rasero3/Nanopipets/README.md

# Nanopipets

MatLab(UART) --> FPGA(UART-SPI) --> DAC
ADC(SPI) --> FPGA(SPI-UART) --> MatLab(UART)

El DAC genera picos de la tension deseada cada 10Hz
