rasero3/Nanopipets/KiCad/Nanopipetes/Nanopipetes.kicad_pcb

## KiCad design KiCad/Nanopipetes/Nanopipetes.kicad_pcb (2025-12-02)

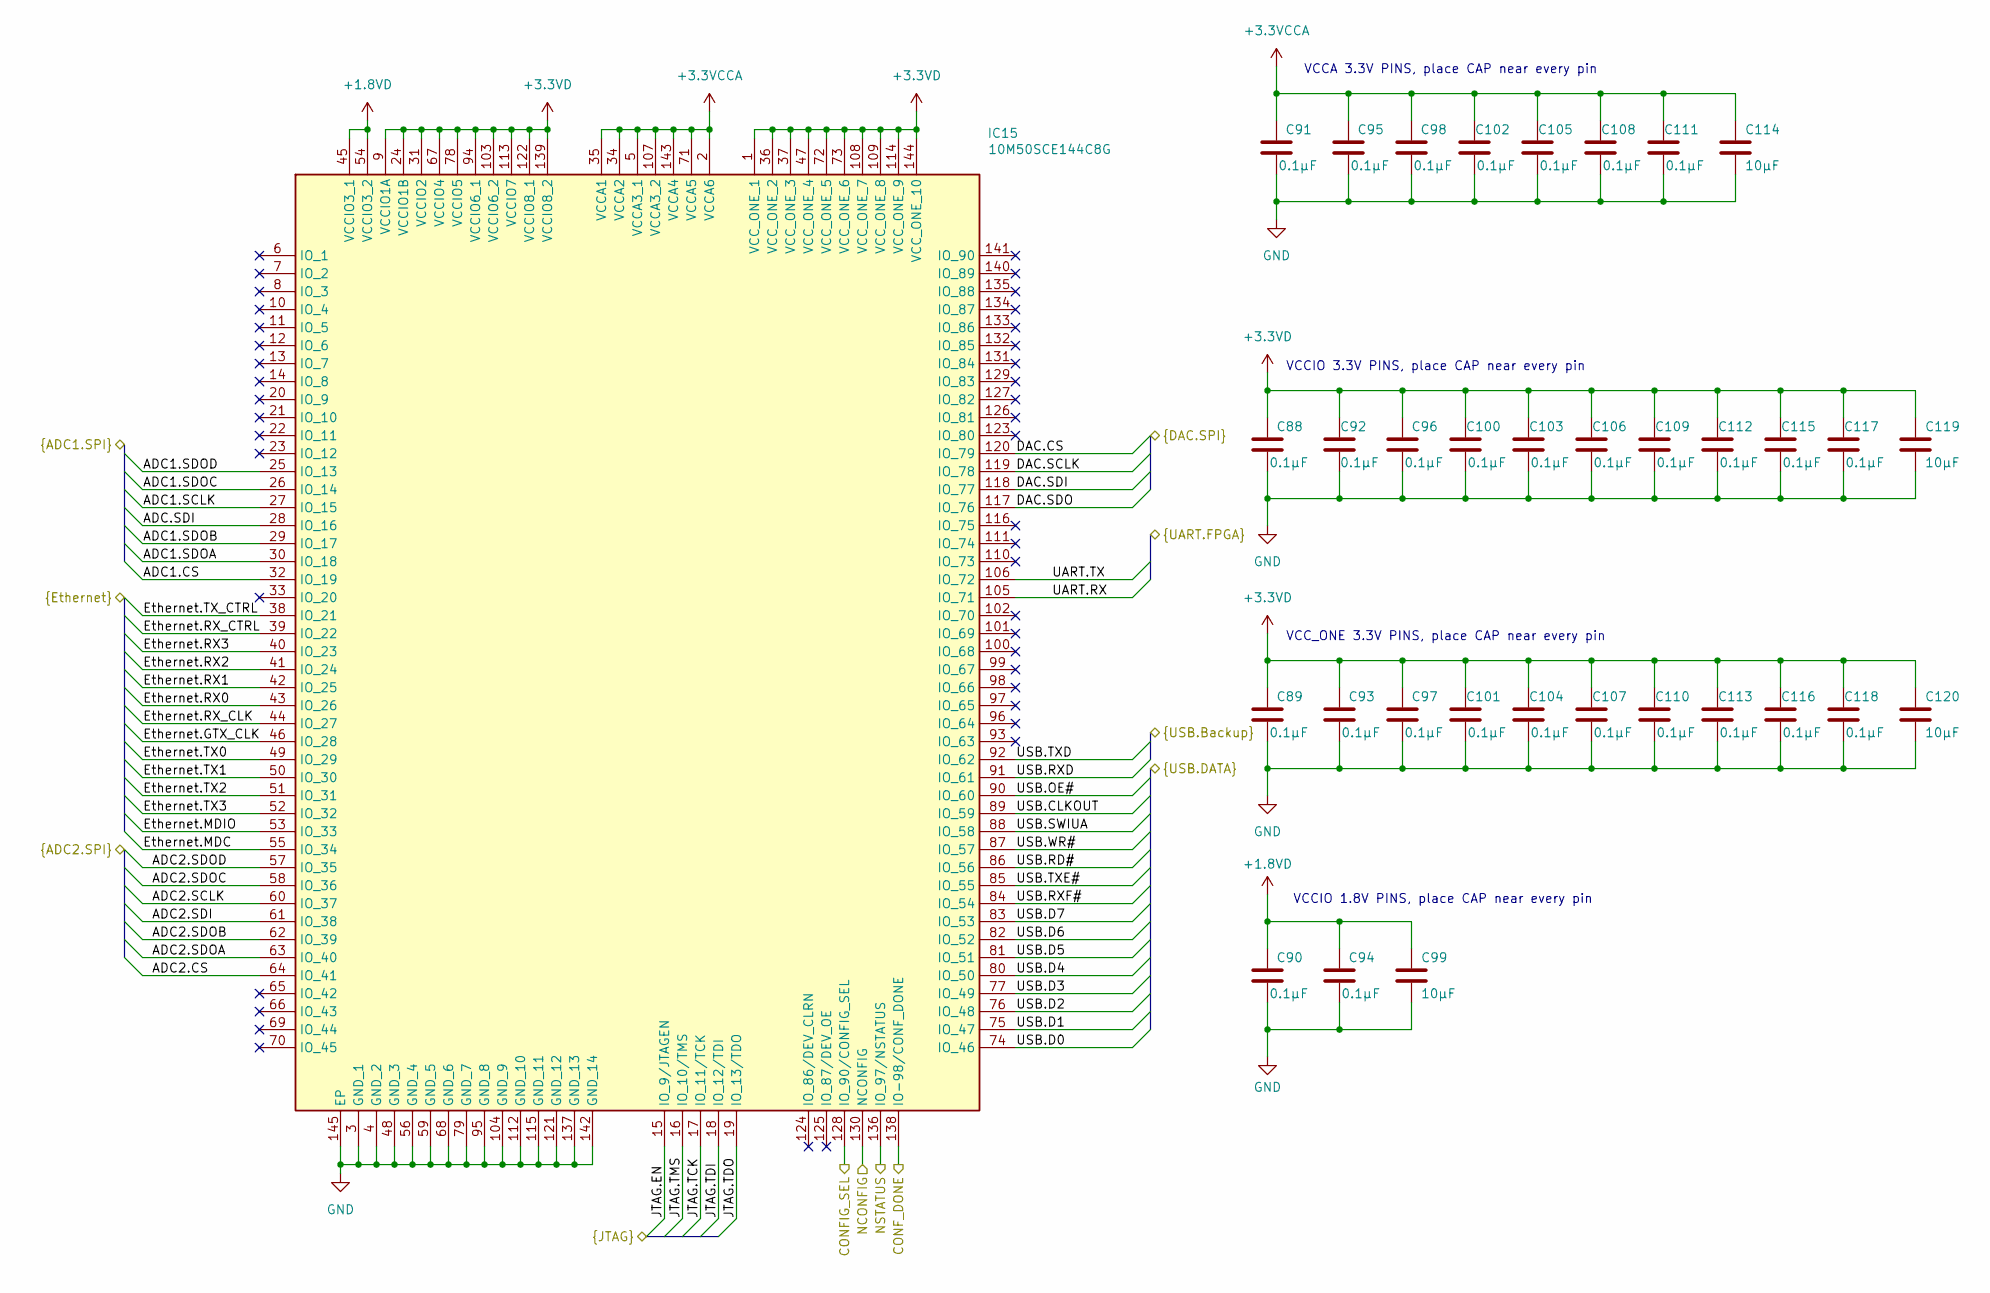
[picture p1: schematic FPGA.kicad_sch]

Parts:
C88, C89, C90, C91, C92, C93, C94, C95, C96, C97, C98, C100, C101, C102, C103, C104, C105, C106, C107, C108, C109, C110, C111, C112, C113, C115, C116, C117, C118: 0.1µF; C_0402_1005Metric; Mouser Part Number 581-0402YC104JAT4A
C99, C114, C119, C120: 10µF; C_0603_1608Metric; Mouser Part Number 80-C0603C106J3RACTU
IC15: 10M50SCE144C8G; QFP50P2200X2200X165-145N; Manufacturer_Part_Number 10M50SCE144C8G; Mouser Part Number 989-10M50SCE144C8G

Connections:
+1.8VD: C90.2, C94.2, C99.1, IC15.45 (VCCIO3_1), IC15.54 (VCCIO3_2); also elsewhere on the board
+3.3VCCA: C91.2, C95.2, C98.2, C102.2, C105.2, C108.2, C111.2, C114.1, IC15.2 (VCCA6), IC15.5 (VCCA3_1), IC15.34 (VCCA2), IC15.35 (VCCA1), IC15.71 (VCCA5), IC15.107 (VCCA3_2), IC15.143 (VCCA4); also elsewhere on the board
+3.3VD: C88.2, C89.2, C92.2, C93.2, C96.2, C97.2, C100.2, C101.2, C103.2, C104.2, C106.2, C107.2, C109.2, C110.2, C112.2, C113.2, C115.2, C116.2, C117.2, C118.2, C119.1, C120.1, IC15.1 (VCC_ONE_1), IC15.9 (VCCIO1A), IC15.24 (VCCIO1B), IC15.31 (VCCIO2), IC15.36 (VCC_ONE_2), IC15.37 (VCC_ONE_3), IC15.47 (VCC_ONE_4), IC15.67 (VCCIO4), IC15.72 (VCC_ONE_5), IC15.73 (VCC_ONE_6), IC15.78 (VCCIO5), IC15.94 (VCCIO6_1), IC15.103 (VCCIO6_2), IC15.108 (VCC_ONE_7), IC15.109 (VCC_ONE_8), IC15.113 (VCCIO7), IC15.114 (VCC_ONE_9), IC15.122 (VCCIO8_1), IC15.139 (VCCIO8_2), IC15.144 (VCC_ONE_10); also elsewhere on the board
/ADC1/ADC1.CS: IC15.32 (IO_19); also elsewhere on the board
/ADC1/ADC1.SCLK: IC15.27 (IO_15); also elsewhere on the board
/ADC1/ADC1.SDOA: IC15.30 (IO_18); also elsewhere on the board
/ADC1/ADC1.SDOB: IC15.29 (IO_17); also elsewhere on the board
/ADC1/ADC1.SDOC: IC15.26 (IO_14); also elsewhere on the board
/ADC1/ADC1.SDOD: IC15.25 (IO_13); also elsewhere on the board
/ADC1/ADC.SDI: IC15.28 (IO_16); also elsewhere on the board
/ADC2/ADC2.CS: IC15.64 (IO_41); also elsewhere on the board
/ADC2/ADC2.SCLK: IC15.60 (IO_37); also elsewhere on the board
/ADC2/ADC2.SDI: IC15.61 (IO_38); also elsewhere on the board
/ADC2/ADC2.SDOA: IC15.63 (IO_40); also elsewhere on the board
/ADC2/ADC2.SDOB: IC15.62 (IO_39); also elsewhere on the board
/ADC2/ADC2.SDOC: IC15.58 (IO_36); also elsewhere on the board
/ADC2/ADC2.SDOD: IC15.57 (IO_35); also elsewhere on the board
/Connectors/CONFIG_SEL: IC15.128 (IO_90/CONFIG_SEL); also elsewhere on the board
/Connectors/CONF_DONE: IC15.138 (IO-98/CONF_DONE); also elsewhere on the board
/Connectors/JTAG.EN: IC15.15 (IO_9/JTAGEN)
/Connectors/JTAG.TCK: IC15.17 (IO_11/TCK); also elsewhere on the board
/Connectors/JTAG.TDI: IC15.18 (IO_12/TDI); also elsewhere on the board
/Connectors/JTAG.TDO: IC15.19 (IO_13/TDO); also elsewhere on the board
/Connectors/JTAG.TMS: IC15.16 (IO_10/TMS); also elsewhere on the board
/Connectors/NCONFIG: IC15.130 (NCONFIG); also elsewhere on the board
/Connectors/NSTATUS: IC15.136 (IO_97/NSTATUS); also elsewhere on the board
/Connectors/UART.RX: IC15.105 (IO_71); also elsewhere on the board
/Connectors/UART.TX: IC15.106 (IO_72); also elsewhere on the board
/DAC/DAC.CS: IC15.120 (IO_79); also elsewhere on the board
/DAC/DAC.SCLK: IC15.119 (IO_78); also elsewhere on the board
/DAC/DAC.SDI: IC15.118 (IO_77); also elsewhere on the board
/DAC/DAC.SDO: IC15.117 (IO_76); also elsewhere on the board
/Ethernet/Ethernet.GTX_CLK: IC15.46 (IO_28); also elsewhere on the board
/Ethernet/Ethernet.MDC: IC15.55 (IO_34); also elsewhere on the board
/Ethernet/Ethernet.MDIO: IC15.53 (IO_33); also elsewhere on the board
/Ethernet/Ethernet.RX0: IC15.43 (IO_26); also elsewhere on the board
/Ethernet/Ethernet.RX1: IC15.42 (IO_25); also elsewhere on the board
/Ethernet/Ethernet.RX2: IC15.41 (IO_24); also elsewhere on the board
/Ethernet/Ethernet.RX3: IC15.40 (IO_23); also elsewhere on the board
/Ethernet/Ethernet.RX_CLK: IC15.44 (IO_27); also elsewhere on the board
/Ethernet/Ethernet.RX_CTRL: IC15.39 (IO_22); also elsewhere on the board
/Ethernet/Ethernet.TX0: IC15.49 (IO_29); also elsewhere on the board
/Ethernet/Ethernet.TX1: IC15.50 (IO_30); also elsewhere on the board
/Ethernet/Ethernet.TX2: IC15.51 (IO_31); also elsewhere on the board
/Ethernet/Ethernet.TX3: IC15.52 (IO_32); also elsewhere on the board
/Ethernet/Ethernet.TX_CTRL: IC15.38 (IO_21); also elsewhere on the board
/FPGA/USB.CLKOUT: IC15.89 (IO_59); also elsewhere on the board
/FPGA/USB.D0: IC15.74 (IO_46); also elsewhere on the board
/FPGA/USB.D1: IC15.75 (IO_47); also elsewhere on the board
/FPGA/USB.D2: IC15.76 (IO_48); also elsewhere on the board
/FPGA/USB.D3: IC15.77 (IO_49); also elsewhere on the board
/FPGA/USB.D4: IC15.80 (IO_50); also elsewhere on the board
/FPGA/USB.D5: IC15.81 (IO_51); also elsewhere on the board
/FPGA/USB.D6: IC15.82 (IO_52); also elsewhere on the board
/FPGA/USB.D7: IC15.83 (IO_53); also elsewhere on the board
/FPGA/USB.OE#: IC15.90 (IO_60); also elsewhere on the board
/FPGA/USB.RD#: IC15.86 (IO_56); also elsewhere on the board
/FPGA/USB.RXD: IC15.91 (IO_61); also elsewhere on the board
/FPGA/USB.RXF#: IC15.84 (IO_54); also elsewhere on the board
/FPGA/USB.SWIUA: IC15.88 (IO_58); also elsewhere on the board
/FPGA/USB.TXD: IC15.92 (IO_62); also elsewhere on the board
/FPGA/USB.TXE#: IC15.85 (IO_55); also elsewhere on the board
/FPGA/USB.WR#: IC15.87 (IO_57); also elsewhere on the board
GND: C88.1, C89.1, C90.1, C91.1, C92.1, C93.1, C94.1, C95.1, C96.1, C97.1, C98.1, C99.2, C100.1, C101.1, C102.1, C103.1, C104.1, C105.1, C106.1, C107.1, C108.1, C109.1, C110.1, C111.1, C112.1, C113.1, C114.2, C115.1, C116.1, C117.1, C118.1, C119.2, C120.2, IC15.3 (GND_1), IC15.4 (GND_2), IC15.48 (GND_3), IC15.56 (GND_4), IC15.59 (GND_5), IC15.68 (GND_6), IC15.79 (GND_7), IC15.95 (GND_8), IC15.104 (GND_9), IC15.112 (GND_10), IC15.115 (GND_11), IC15.121 (GND_12), IC15.137 (GND_13), IC15.142 (GND_14), IC15.145 (EP); also elsewhere on the board

Notes on the sheet:
VCC_ONE 3.3V PINS, place CAP near every pin
VCCA 3.3V PINS, place CAP near every pin
VCCIO 1.8V PINS, place CAP near every pin
VCCIO 3.3V PINS, place CAP near every pin

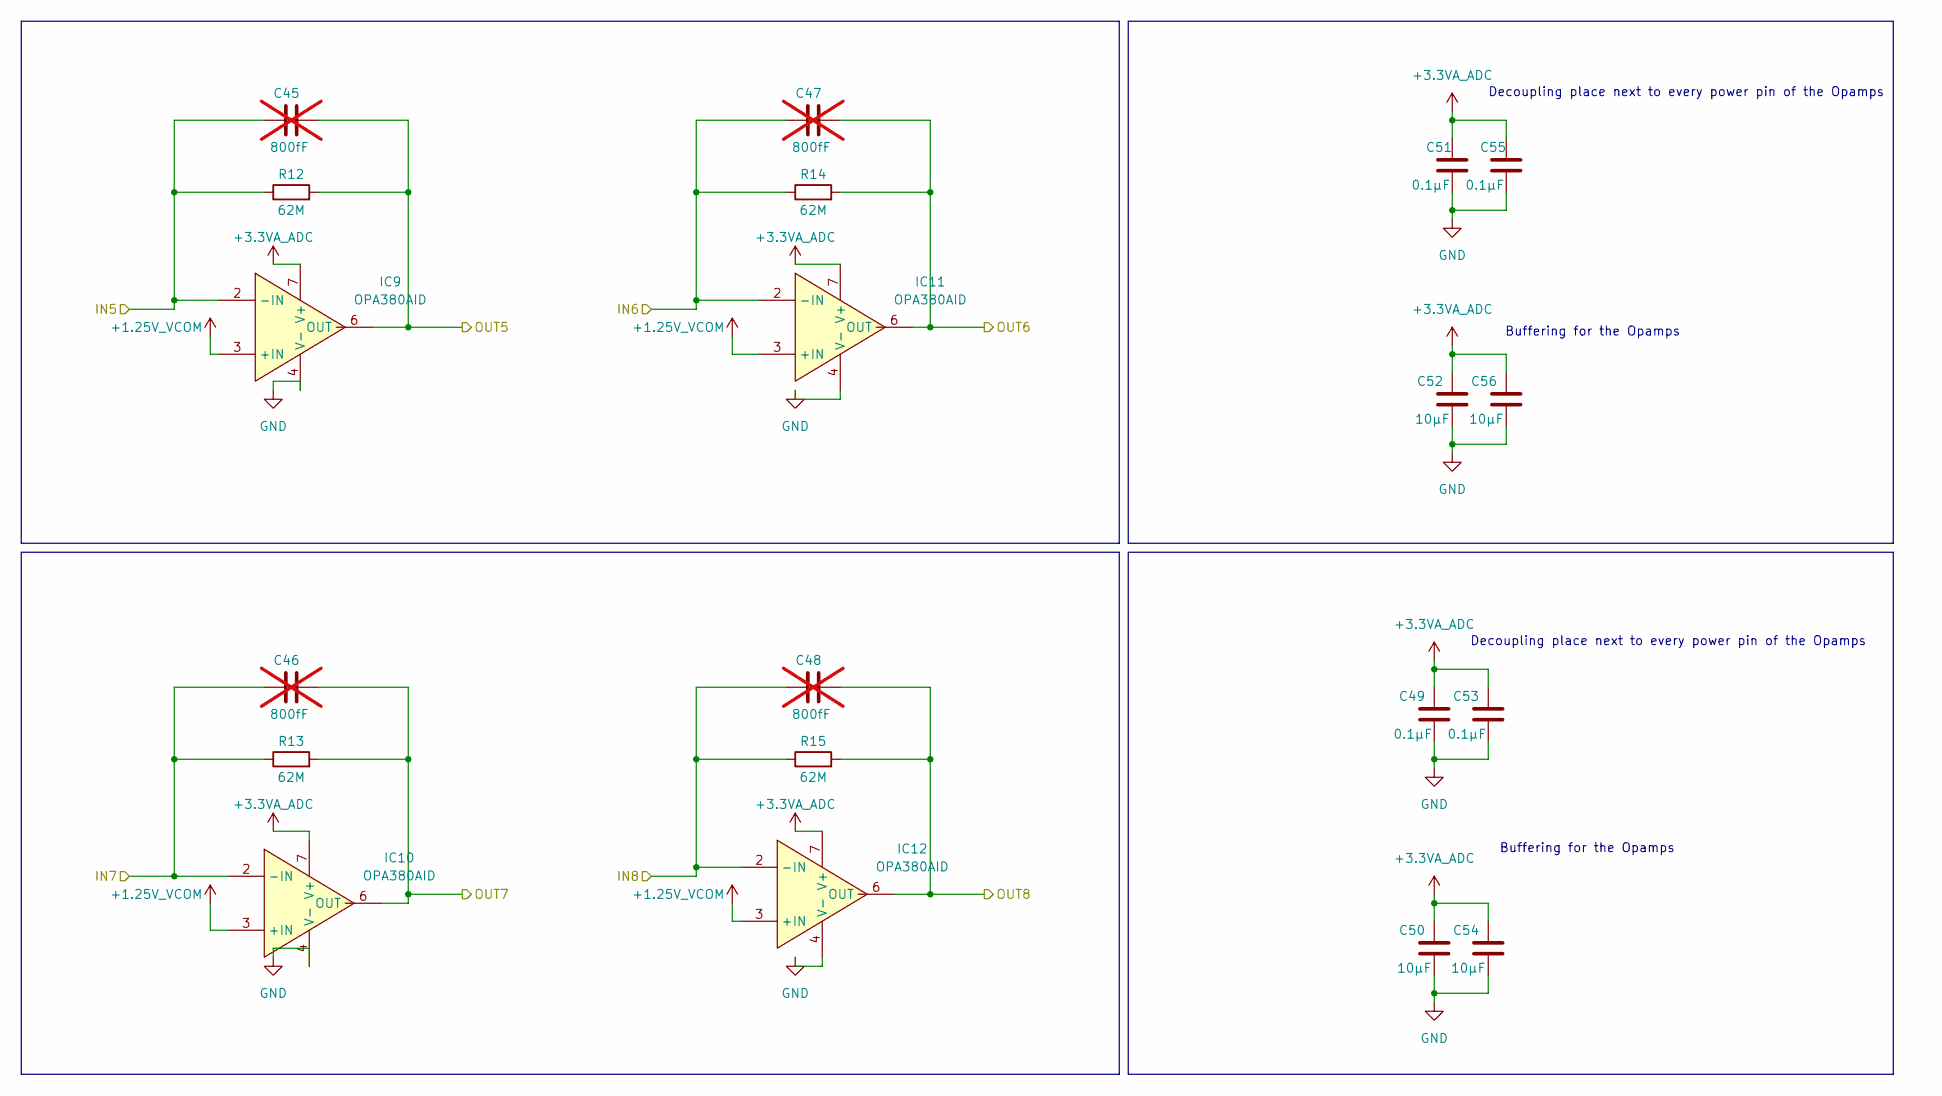
[picture p2: schematic IV_Converter2.kicad_sch]

Parts:
C45, C46, C47, C48: 800fF; C_0402_1005Metric; Mouser Part Number 81-GCM1555C2AR80BE2D; not fitted
C49, C51, C53, C55: 0.1µF; C_0402_1005Metric; Mouser Part Number 581-0402YC104JAT4A
C50, C52, C54, C56: 10µF; C_0603_1608Metric; Mouser Part Number 80-C0603C106J3RACTU
IC9, IC10, IC11, IC12: OPA380AID; SOIC127P600X175-8N; Mouser Part Number 595-OPA380AID
R12, R13, R14, R15: 62M; R_0603_1608Metric; Mouser Part Number 71-RCW120662M0JPEAHR

Connections:
+1.25V_VCOM: IC9.3 (+IN), IC10.3 (+IN), IC11.3 (+IN), IC12.3 (+IN); also elsewhere on the board
+3.3VA_ADC: C49.1, C50.1, C51.1, C52.1, C53.1, C54.1, C55.1, C56.1, IC9.7 (V+), IC10.7 (V+), IC11.7 (V+), IC12.7 (V+); also elsewhere on the board
/ADC2/IN5: C45.2, IC9.6 (OUT), R12.2; also elsewhere on the board
/ADC2/IN6: C47.2, IC11.6 (OUT), R14.2; also elsewhere on the board
/ADC2/IN7: C46.2, IC10.6 (OUT), R13.2; also elsewhere on the board
/ADC2/IN8: C48.2, IC12.6 (OUT), R15.2; also elsewhere on the board
/Connectors/IN5: C45.1, IC9.2 (-IN), R12.1; also elsewhere on the board
/Connectors/IN6: C47.1, IC11.2 (-IN), R14.1; also elsewhere on the board
/Connectors/IN7: C46.1, IC10.2 (-IN), R13.1; also elsewhere on the board
/Connectors/IN8: C48.1, IC12.2 (-IN), R15.1; also elsewhere on the board
GND: C49.2, C50.2, C51.2, C52.2, C53.2, C54.2, C55.2, C56.2, IC9.4 (V-), IC10.4 (V-), IC11.4 (V-), IC12.4 (V-); also elsewhere on the board

Notes on the sheet:
Buffering for the Opamps
Decoupling place next to every power pin of the Opamps

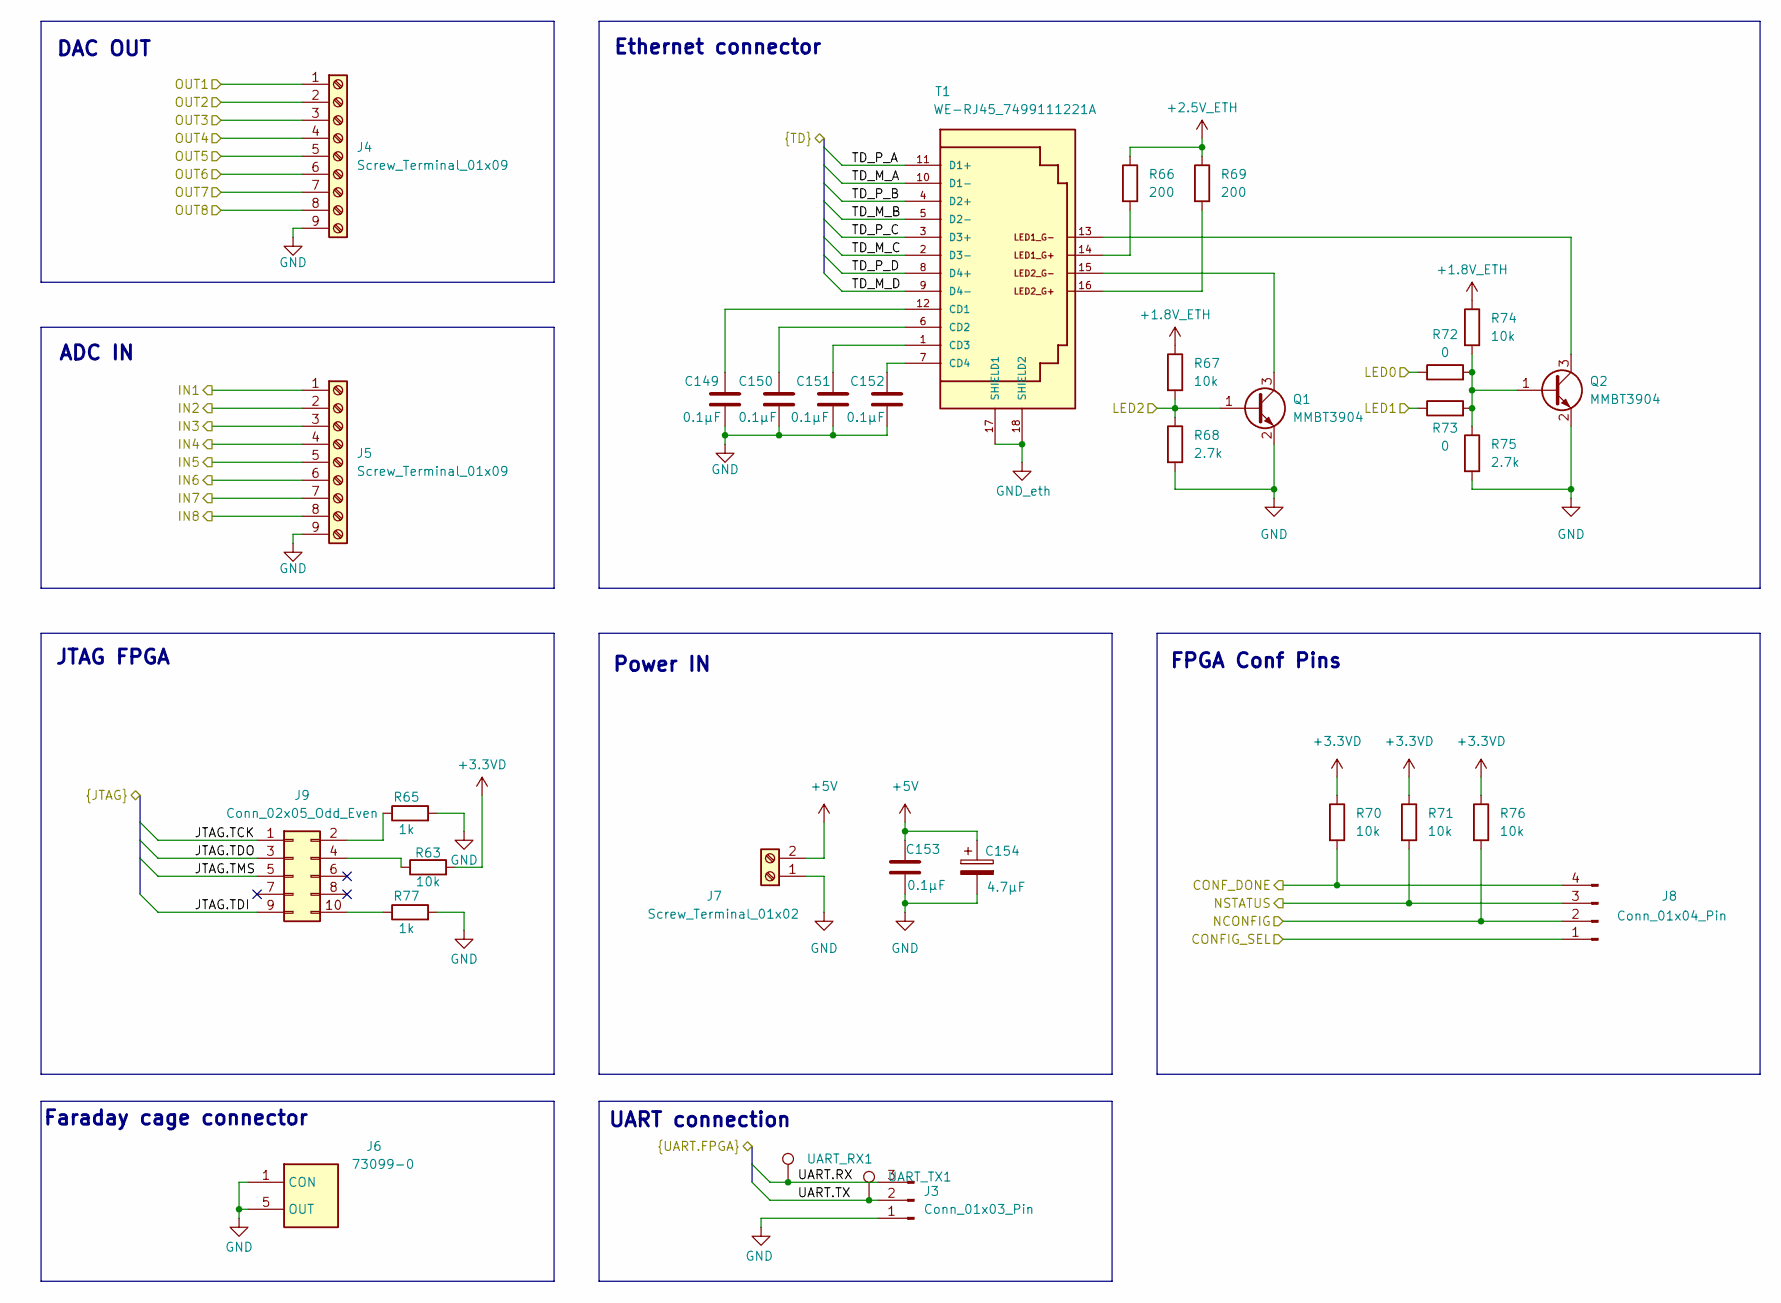
[picture p3: schematic Connectors.kicad_sch]

Parts:
C149, C150, C151, C152, C153: 0.1µF; C_0402_1005Metric; Mouser Part Number 581-0402YC104JAT4A
C154: 4.7µF; CP_EIA-3216-12_Kemet-S; Mouser Part Number 71-293D475X5010A2TE3
J3: Conn_01x03_Pin; PinHeader_1x03_P2.54mm_Vertical
J4, J5: Screw_Terminal_01x09; TerminalBlock_Phoenix_MKDS-1,5-9-5.08_1x09_P5.08mm_Horizont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
J6: 73099-0; 730990; Manufacturer_Part_Number 73099-0; Mouser Part Number 565-73099-0
J7: Screw_Terminal_01x02; TerminalBlock_Phoenix_MKDS-1,5-2-5.08_1x02_P5.08mm_Horizont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
J8: Conn_01x04_Pin; PinHeader_1x04_P2.54mm_Vertical
J9: Conn_02x05_Odd_Even; PinHeader_2x05_P2.54mm_Vertical
Q1, Q2: MMBT3904; SOT-23
R63, R67, R70, R71, R74, R76: 10k; R_0603_1608Metric; Mouser Part Number 71-RCA060310K0JNEA
R65, R77: 1k; R_0603_1608Metric; Mouser Part Number 71-CRCW06031K00JNED
R66, R69: 200; R_0603_1608Metric; Mouser Part Number 303-CQ03WAJ0201T5E
R68, R75: 2.7k; R_0603_1608Metric; Mouser Part Number 603-AR0603JR-072K7L
R72: 0; R_0603_1608Metric; Mouser Part Number 791-WR06X000PTR
R73: 0; R_0603_1608Metric
T1: WE-RJ45_7499111221A; 7499111221A; Mouser Part Number 710-7499111221A
UART_RX1: TestPoint; TestPoint_Keystone_5000-5004_Miniature
UART_TX1: TestPoint; TestPoint_Keystone_5000-5004_Miniature

Connections:
+1.8VD: R67.1, R74.1; also elsewhere on the board
+2.5V_ETH: R66.1, R69.1; also elsewhere on the board
+3.3VD: R63.2, R70.1, R71.1, R76.1; also elsewhere on the board
+5V: C153.2, C154.1, J7.2; also elsewhere on the board
/Connectors/CONFIG_SEL: J8.1; also elsewhere on the board
/Connectors/CONF_DONE: J8.4, R70.2; also elsewhere on the board
/Connectors/IN1: J5.1; also elsewhere on the board
/Connectors/IN2: J5.2; also elsewhere on the board
/Connectors/IN3: J5.3; also elsewhere on the board
/Connectors/IN4: J5.4; also elsewhere on the board
/Connectors/IN5: J5.5; also elsewhere on the board
/Connectors/IN6: J5.6; also elsewhere on the board
/Connectors/IN7: J5.7; also elsewhere on the board
/Connectors/IN8: J5.8; also elsewhere on the board
/Connectors/JTAG.TCK: J9.1; also elsewhere on the board
/Connectors/JTAG.TDI: J9.9; also elsewhere on the board
/Connectors/JTAG.TDO: J9.3; also elsewhere on the board
/Connectors/JTAG.TMS: J9.5; also elsewhere on the board
/Connectors/LED0: R72.1; also elsewhere on the board
/Connectors/LED1: R73.1; also elsewhere on the board
/Connectors/LED2: Q1.1 (B), R67.2, R68.1; also elsewhere on the board
/Connectors/NCONFIG: J8.2, R76.2; also elsewhere on the board
/Connectors/NSTATUS: J8.3, R71.2; also elsewhere on the board
/Connectors/OUT1: J4.1; also elsewhere on the board
/Connectors/OUT2: J4.2; also elsewhere on the board
/Connectors/OUT3: J4.3; also elsewhere on the board
/Connectors/OUT4: J4.4; also elsewhere on the board
/Connectors/OUT5: J4.5; also elsewhere on the board
/Connectors/OUT6: J4.6; also elsewhere on the board
/Connectors/OUT7: J4.7; also elsewhere on the board
/Connectors/OUT8: J4.8; also elsewhere on the board
/Connectors/TD_M_A: T1.10 (D1-); also elsewhere on the board
/Connectors/TD_M_B: T1.5 (D2-); also elsewhere on the board
/Connectors/TD_M_C: T1.2 (D3-); also elsewhere on the board
/Connectors/TD_M_D: T1.9 (D4-); also elsewhere on the board
/Connectors/TD_P_A: T1.11 (D1+); also elsewhere on the board
/Connectors/TD_P_B: T1.4 (D2+); also elsewhere on the board
/Connectors/TD_P_C: T1.3 (D3+); also elsewhere on the board
/Connectors/TD_P_D: T1.8 (D4+); also elsewhere on the board
/Connectors/UART.RX: J3.3, UART_RX1.1; also elsewhere on the board
/Connectors/UART.TX: J3.2, UART_TX1.1; also elsewhere on the board
GND: C149.2, C150.2, C151.2, C152.2, C153.1, C154.2, J3.1, J4.9, J5.9, J6.1 (CON), J6.2, J6.3, J6.4, J6.5 (OUT), J7.1, Q1.2 (E), Q2.2 (E), R65.2, R68.2, R75.2, R77.2, T1.17 (SHIELD1), T1.18 (SHIELD2); also elsewhere on the board
unnamed: J9.2, R65.1
unnamed: J9.4, R63.1
unnamed: J9.10, R77.1
unnamed: Q1.3 (C), T1.15
unnamed: Q2.1 (B), R72.2, R73.2, R74.2, R75.1
unnamed: Q2.3 (C), T1.13
unnamed: R66.2, T1.14
unnamed: R69.2, T1.16
unnamed: C149.1, T1.12 (CD1)
unnamed: C150.1, T1.6 (CD2)
unnamed: C151.1, T1.1 (CD3)
unnamed: C152.1, T1.7 (CD4)

Notes on the sheet:
UART connection
Faraday cage connector
Ethernet connector
ADC IN
JTAG FPGA
Power IN
DAC OUT
FPGA Conf Pins

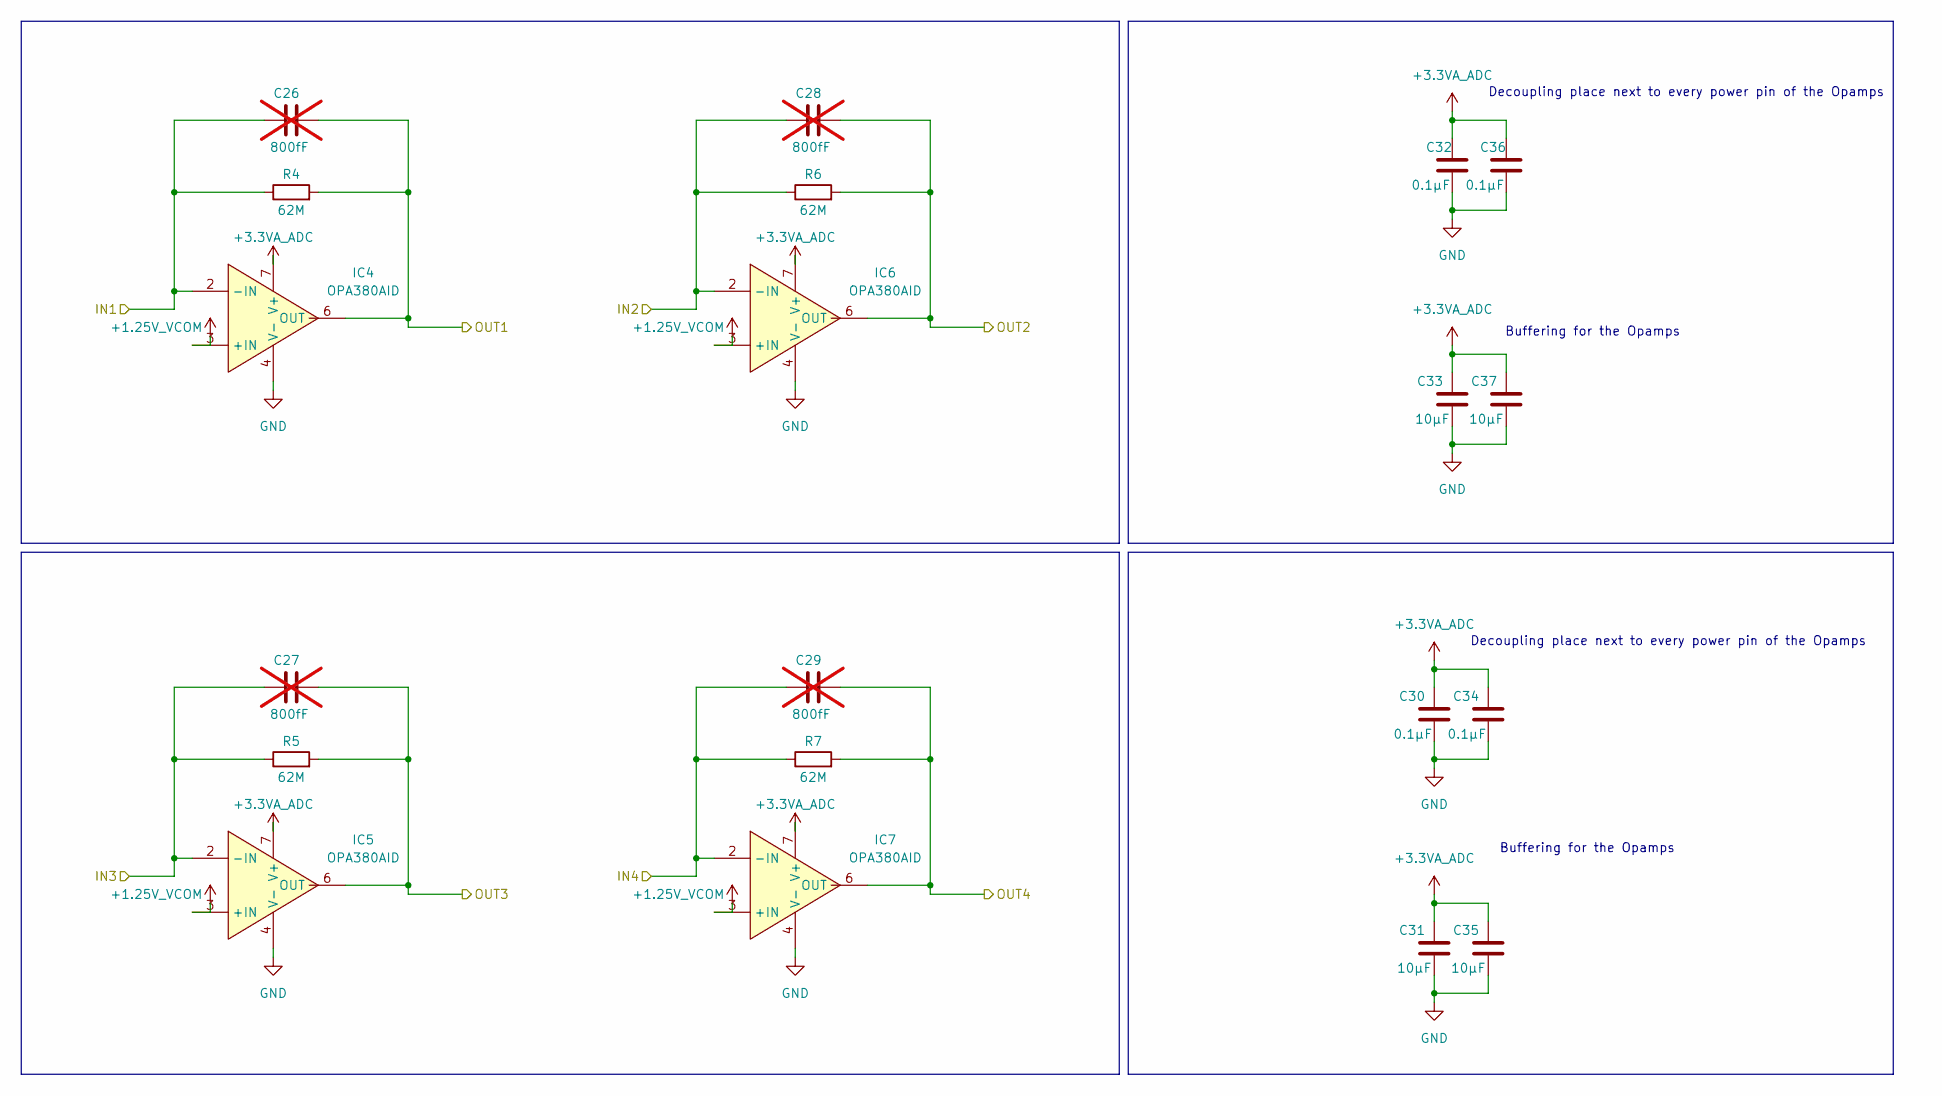
[picture p4: schematic IV_Converter1.kicad_sch]

Parts:
C26, C27, C28, C29: 800fF; C_0402_1005Metric; Mouser Part Number 81-GCM1555C2AR80BE2D; not fitted
C30, C32, C34, C36: 0.1µF; C_0402_1005Metric; Mouser Part Number 581-0402YC104JAT4A
C31, C33, C35, C37: 10µF; C_0603_1608Metric; Mouser Part Number 80-C0603C106J3RACTU
IC4, IC5, IC6, IC7: OPA380AID; SOIC127P600X175-8N; Mouser Part Number 595-OPA380AID
R4, R5, R6, R7: 62M; R_1206_3216Metric; Mouser Part Number 71-RCW120662M0JPEAHR

Connections:
+1.25V_VCOM: IC4.3 (+IN), IC5.3 (+IN), IC6.3 (+IN), IC7.3 (+IN); also elsewhere on the board
+3.3VA_ADC: C30.1, C31.1, C32.1, C33.1, C34.1, C35.1, C36.1, C37.1, IC4.7 (V+), IC5.7 (V+), IC6.7 (V+), IC7.7 (V+); also elsewhere on the board
/ADC1/IN1: C26.2, IC4.6 (OUT), R4.2; also elsewhere on the board
/ADC1/IN2: C28.2, IC6.6 (OUT), R6.2; also elsewhere on the board
/ADC1/IN3: C27.2, IC5.6 (OUT), R5.2; also elsewhere on the board
/ADC1/IN4: C29.2, IC7.6 (OUT), R7.2; also elsewhere on the board
/Connectors/IN1: C26.1, IC4.2 (-IN), R4.1; also elsewhere on the board
/Connectors/IN2: C28.1, IC6.2 (-IN), R6.1; also elsewhere on the board
/Connectors/IN3: C27.1, IC5.2 (-IN), R5.1; also elsewhere on the board
/Connectors/IN4: C29.1, IC7.2 (-IN), R7.1; also elsewhere on the board
GND: C30.2, C31.2, C32.2, C33.2, C34.2, C35.2, C36.2, C37.2, IC4.4 (V-), IC5.4 (V-), IC6.4 (V-), IC7.4 (V-); also elsewhere on the board

Notes on the sheet:
Decoupling place next to every power pin of the Opamps
Buffering for the Opamps

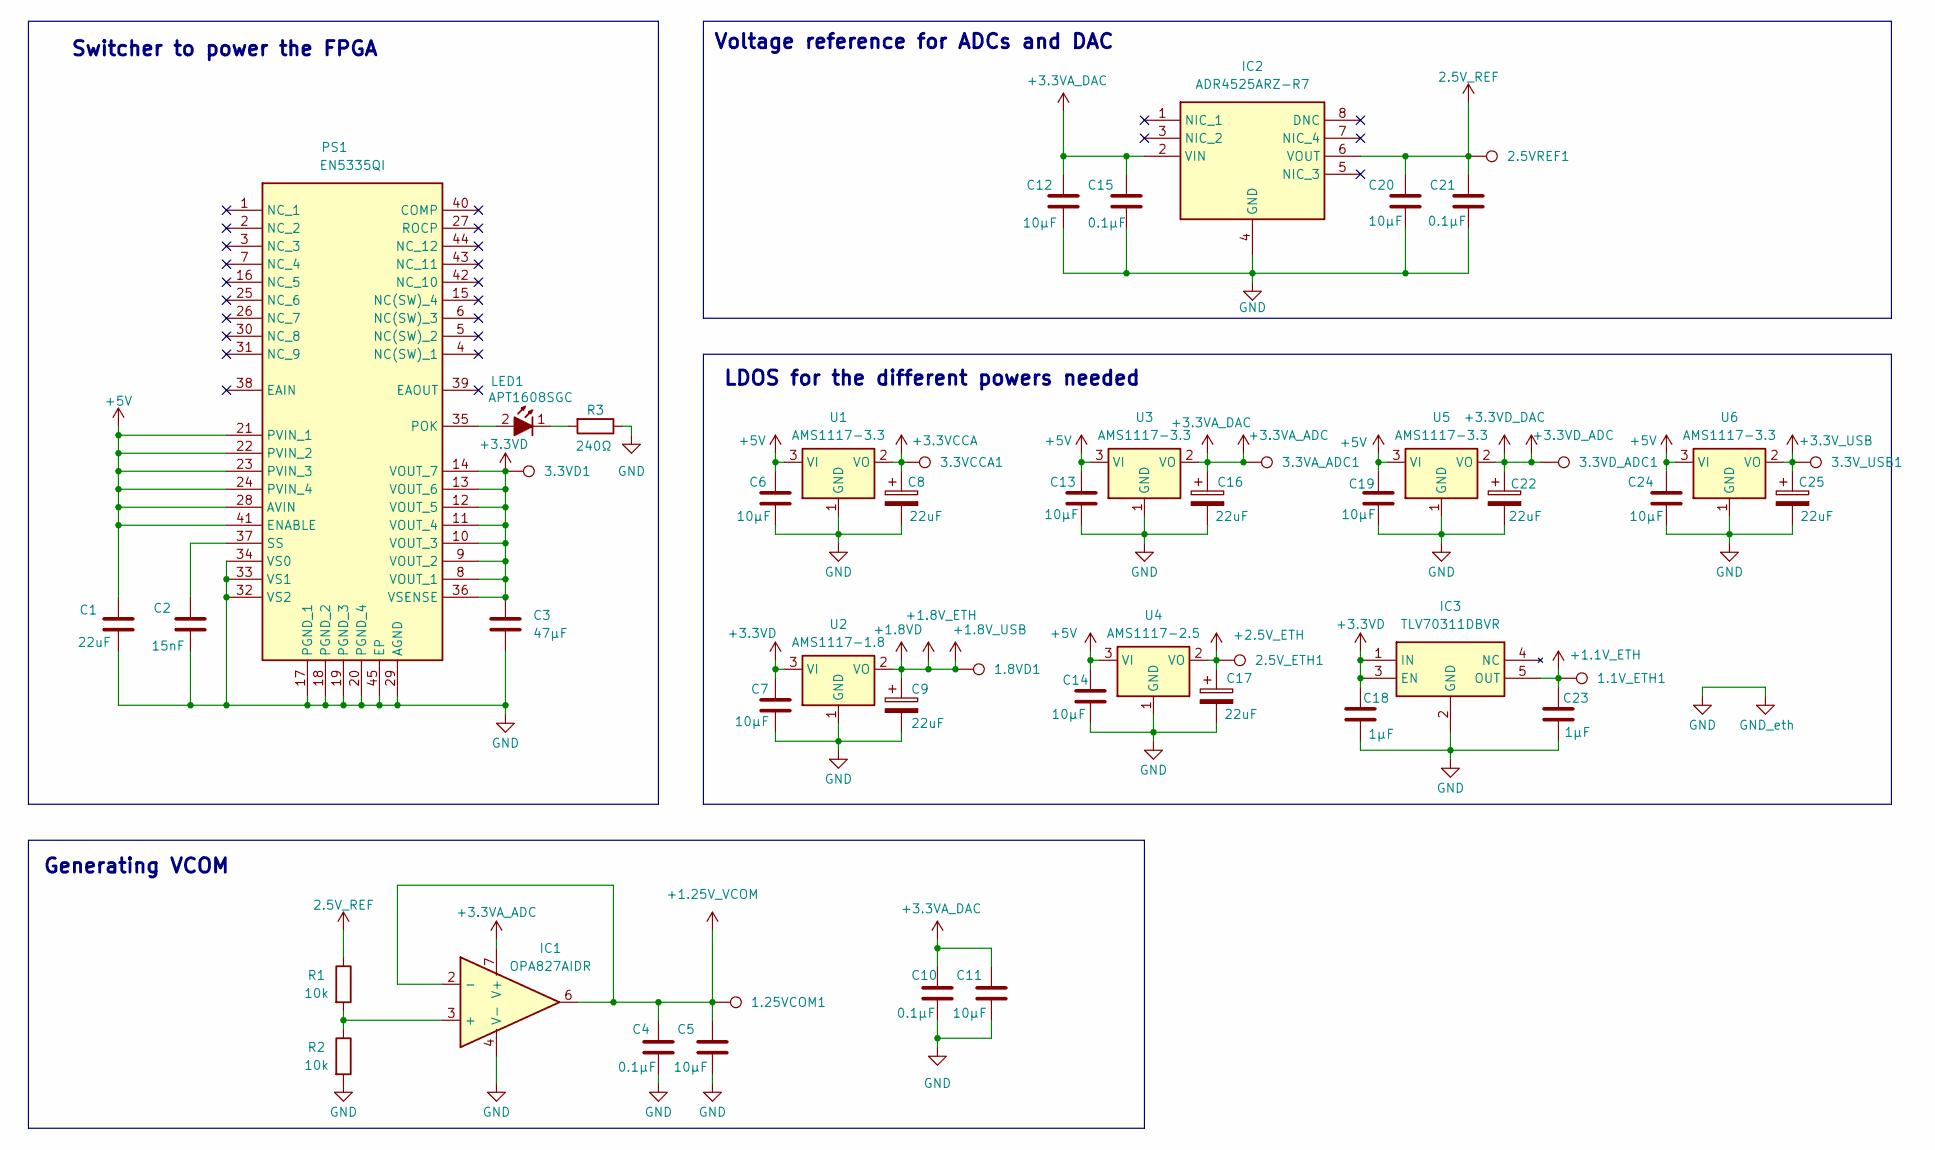
[picture p5: schematic Power.kicad_sch]

Parts:
1.1V_ETH1, 1.8VD1, 1.25VCOM1, 2.5VREF1, 2.5V_ETH1, 3.3VA_ADC1, 3.3VCCA1, 3.3VD1, 3.3VD_ADC1, 3.3V_USB1: TestPoint; TestPoint_Keystone_5000-5004_Miniature
C1: 22uF; C_0805_2012Metric; Mouser Part Number 791-1206X226J6R3CT
C2: 15nF; C_0402_1005Metric; Mouser Part Number 77-VJ0402Y153JXJCBC
C3: 47µF; C_1206_3216Metric; Mouser Part Number GGM32ED70J476KE02L
C4, C10, C15, C21: 0.1µF; C_0402_1005Metric; Mouser Part Number 581-0402YC104JAT4A
C5, C6, C7, C11, C12, C13, C14, C19, C20, C24: 10µF; C_0603_1608Metric; Mouser Part Number 80-C0603C106J3RACTU
C8, C9, C16, C17, C22, C25: 22uF; CP_EIA-3216-18_Kemet-A; Mouser Part Number 581-TBJB226J006CS700
C18, C23: 1µF; C_0603_1608Metric; Mouser Part Number 581-KGM15BR71A105JT
IC1: OPA827AIDR; SOIC127P600X175-8N; Manufacturer_Part_Number OPA827AIDR; Mouser Part Number 595-OPA827AIDR
IC2: ADR4525ARZ-R7; SOIC127P600X175-8N; Manufacturer_Part_Number ADR4525ARZ-R7; Mouser Part Number 584-ADR4525ARZ-R7
IC3: TLV70311DBVR; SOT95P280X145-5N; Manufacturer_Part_Number TLV70311DBVR; Mouser Part Number 595-TLV70311DBVR
LED1: APT1608SGC; LEDC1608X85N; Manufacturer_Part_Number APT1608SGC; Mouser Part Number 604-APT1608SGC
PS1: EN5335QI; Manufacturer_Part_Number EN5335QI; Mouser Part Number 884-EN5335QI
R1, R2: 10k; R_0603_1608Metric; Mouser Part Number 71-RCA060310K0JNEA
R3: 240Ω; R_0603_1608Metric; Mouser Part Number 603-AR0603JR-07240RL
U1, U3, U5, U6: AMS1117-3.3; SOT-223-3_TabPin2
U2: AMS1117-1.8; SOT-223-3_TabPin2
U4: AMS1117-2.5; SOT-223-3_TabPin2

Connections:
2.5V_REF: 2.5VREF1.1, C20.1, C21.1, IC2.6 (VOUT), R1.1; also elsewhere on the board
+1.1V_ETH: 1.1V_ETH1.1, C23.1, IC3.5 (OUT); also elsewhere on the board
+1.8VD: 1.8VD1.1, C9.1, U2.2 (VO); also elsewhere on the board
+1.25V_VCOM: 1.25VCOM1.1, C4.1, C5.1, IC1.2 (-), IC1.6; also elsewhere on the board
+2.5V_ETH: 2.5V_ETH1.1, C17.1, U4.2 (VO); also elsewhere on the board
+3.3VA_ADC: 3.3VA_ADC1.1, C10.1, C11.1, C12.1, C15.1, C16.1, IC1.7 (V+), IC2.2 (VIN), U3.2 (VO); also elsewhere on the board
+3.3VCCA: 3.3VCCA1.1, C8.1, U1.2 (VO); also elsewhere on the board
+3.3VD: 3.3VD1.1, C3.1, C7.1, C18.1, IC3.1 (IN), IC3.3 (EN), PS1.8 (VOUT_1), PS1.9 (VOUT_2), PS1.10 (VOUT_3), PS1.11 (VOUT_4), PS1.12 (VOUT_5), PS1.13 (VOUT_6), PS1.14 (VOUT_7), PS1.36 (VSENSE), U2.3 (VI); also elsewhere on the board
+3.3VD_ADC: 3.3VD_ADC1.1, C22.1, U5.2 (VO); also elsewhere on the board
+3.3V_USB: 3.3V_USB1.1, C25.1, U6.2 (VO); also elsewhere on the board
+5V: C1.1, C6.1, C13.1, C14.1, C19.1, C24.1, PS1.21 (PVIN_1), PS1.22 (PVIN_2), PS1.23 (PVIN_3), PS1.24 (PVIN_4), PS1.28 (AVIN), PS1.41 (ENABLE), U1.3 (VI), U3.3 (VI), U4.3 (VI), U5.3 (VI), U6.3 (VI); also elsewhere on the board
GND: C1.2, C2.2, C3.2, C4.2, C5.2, C6.2, C7.2, C8.2, C9.2, C10.2, C11.2, C12.2, C13.2, C14.2, C15.2, C16.2, C17.2, C18.2, C19.2, C20.2, C21.2, C22.2, C23.2, C24.2, C25.2, IC1.4 (V-), IC2.4 (GND), IC3.2 (GND), PS1.17 (PGND_1), PS1.18 (PGND_2), PS1.19 (PGND_3), PS1.20 (PGND_4), PS1.29 (AGND), PS1.32 (VS2), PS1.33 (VS1), PS1.34 (VS0), PS1.45 (EP), R2.2, R3.1, U1.1 (GND), U2.1 (GND), U3.1 (GND), U4.1 (GND), U5.1 (GND), U6.1 (GND); also elsewhere on the board
unnamed: IC1.3 (+), R1.2, R2.1
unnamed: LED1.2 (A), PS1.35 (POK)
unnamed: LED1.1 (K), R3.2
unnamed: C2.1, PS1.37 (SS)

Notes on the sheet:
Generating VCOM
LDOS for the different powers needed
Voltage reference for ADCs and DAC
Switcher to power the FPGA
