rasero3/Nanopipets/KiCad/Nanopipetes/Nanopipetes.kicad_pcb

## KiCad design KiCad/Nanopipetes/Nanopipetes.kicad_pcb (continued)

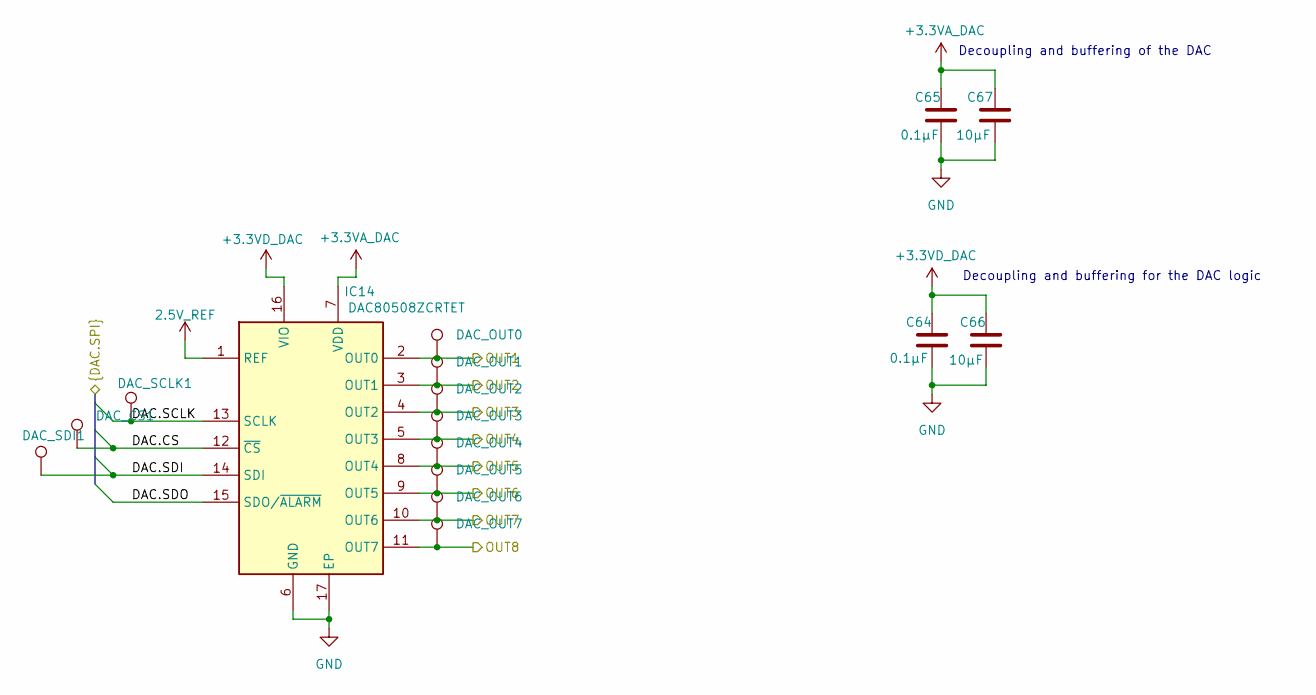
[picture p6: schematic DAC.kicad_sch]

Parts:
C64, C65: 0.1µF; C_0402_1005Metric; Mouser Part Number 581-0402YC104JAT4A
C66, C67: 10µF; C_0603_1608Metric; Mouser Part Number 80-C0603C106J3RACTU
DAC_CS1: TestPoint; TestPoint_Keystone_5000-5004_Miniature
DAC_OUT0, DAC_OUT1, DAC_OUT2, DAC_OUT3, DAC_OUT4, DAC_OUT5, DAC_OUT6, DAC_OUT7: TestPoint; TestPoint_Keystone_5000-5004_Miniature
DAC_SCLK1: TestPoint; TestPoint_Keystone_5000-5004_Miniature
DAC_SDI1: TestPoint; TestPoint_Keystone_5000-5004_Miniature
IC14: DAC80508ZCRTET; QFN50P300X300X80-17N; Manufacturer_Part_Number DAC80508ZCRTET; Mouser Part Number 595-DAC80508ZCRTET

Connections:
2.5V_REF: IC14.1 (REF); also elsewhere on the board
+3.3VA_ADC: C65.1, C67.1, IC14.7 (VDD); also elsewhere on the board
+3.3VD_ADC: C64.1, C66.1, IC14.16 (VIO); also elsewhere on the board
/DAC/DAC.CS: DAC_CS1.1, IC14.12 (~CS); also elsewhere on the board
/DAC/DAC.SCLK: DAC_SCLK1.1, IC14.13 (SCLK); also elsewhere on the board
/DAC/DAC.SDI: DAC_SDI1.1, IC14.14 (SDI); also elsewhere on the board
/DAC/DAC.SDO: IC14.15 (SDO/~ALARM); also elsewhere on the board
/DAC/OUT1: DAC_OUT0.1, IC14.2 (OUT0); also elsewhere on the board
/DAC/OUT2: DAC_OUT1.1, IC14.3 (OUT1); also elsewhere on the board
/DAC/OUT3: DAC_OUT2.1, IC14.4 (OUT2); also elsewhere on the board
/DAC/OUT4: DAC_OUT3.1, IC14.5 (OUT3); also elsewhere on the board
/DAC/OUT5: DAC_OUT4.1, IC14.8 (OUT4); also elsewhere on the board
/DAC/OUT6: DAC_OUT5.1, IC14.9 (OUT5); also elsewhere on the board
/DAC/OUT7: DAC_OUT6.1, IC14.10 (OUT6); also elsewhere on the board
/DAC/OUT8: DAC_OUT7.1, IC14.11 (OUT7); also elsewhere on the board
GND: C64.2, C65.2, C66.2, C67.2, IC14.6 (GND), IC14.17 (EP); also elsewhere on the board

Notes on the sheet:
Decoupling and buffering of the DAC
Decoupling and buffering for the DAC logic

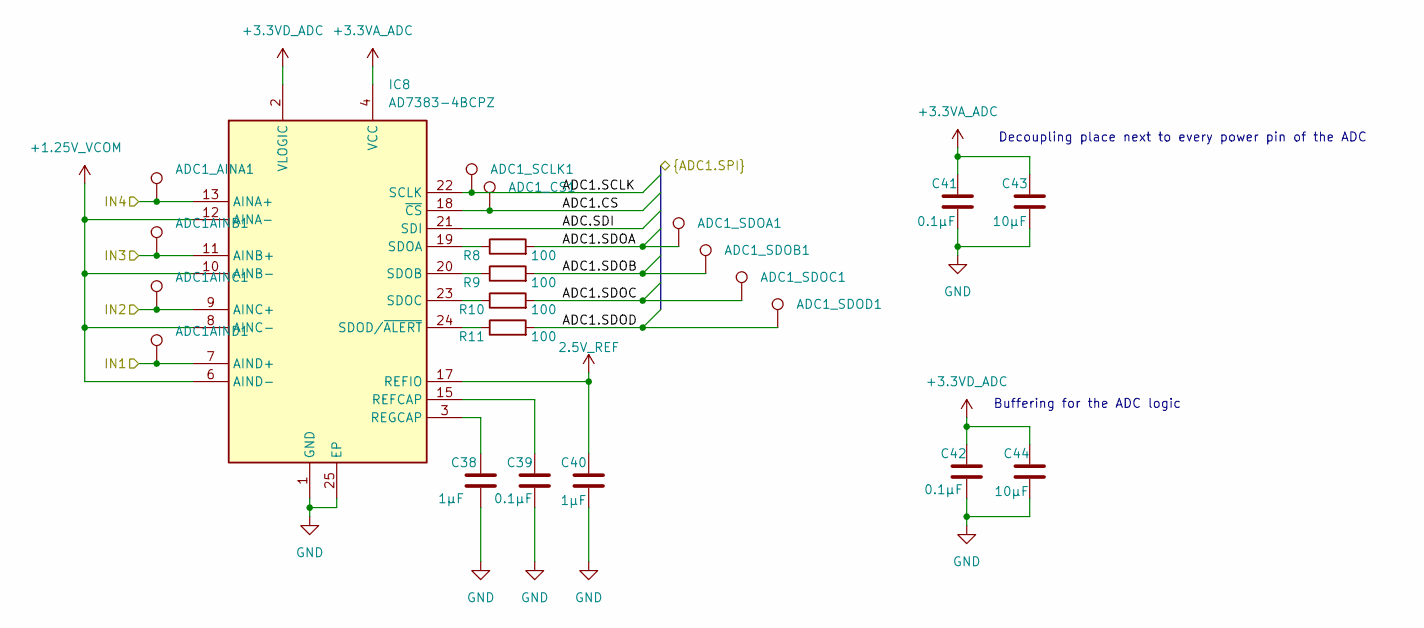
[picture p7: schematic ADC1.kicad_sch]

Parts:
ADC1AINB1, ADC1AINC1, ADC1AIND1, ADC1_AINA1, ADC1_CS1, ADC1_SCLK1, ADC1_SDOA1, ADC1_SDOB1, ADC1_SDOC1, ADC1_SDOD1: TestPoint; TestPoint_Keystone_5000-5004_Miniature
C38: 1µF; C_0402_1005Metric; Mouser Part Number 581-0402YC104JAT4A
C39, C41, C42: 0.1µF; C_0402_1005Metric; Mouser Part Number 581-0402YC104JAT4A
C40: 1µF; C_0603_1608Metric; Mouser Part Number 581-KGM15BR71A105JT
C43, C44: 10µF; C_0603_1608Metric; Mouser Part Number 80-C0603C106J3RACTU
IC8: AD7383-4BCPZ; QFN50P400X400X60-25N-D; Manufacturer_Part_Number AD7383-4BCPZ; Mouser Part Number 584-AD7383-4BCPZ
R8, R9, R10, R11: 100; R_0603_1608Metric; Mouser Part Number 71-RCG0603100RJNEA

Connections:
2.5V_REF: C40.1, IC8.17 (REFIO); also elsewhere on the board
+1.25V_VCOM: IC8.6 (AIND-), IC8.8 (AINC-), IC8.10 (AINB-), IC8.12 (AINA-); also elsewhere on the board
+3.3VA_ADC: C41.1, C43.1, IC8.4 (VCC); also elsewhere on the board
+3.3VD_ADC: C42.1, C44.1, IC8.2 (VLOGIC); also elsewhere on the board
/ADC1/ADC1.CS: ADC1_CS1.1, IC8.18 (~CS); also elsewhere on the board
/ADC1/ADC1.SCLK: ADC1_SCLK1.1, IC8.22 (SCLK); also elsewhere on the board
/ADC1/ADC1.SDOA: ADC1_SDOA1.1, R8.2; also elsewhere on the board
/ADC1/ADC1.SDOB: ADC1_SDOB1.1, R9.2; also elsewhere on the board
/ADC1/ADC1.SDOC: ADC1_SDOC1.1, R10.2; also elsewhere on the board
/ADC1/ADC1.SDOD: ADC1_SDOD1.1, R11.2; also elsewhere on the board
/ADC1/ADC.SDI: IC8.21 (SDI); also elsewhere on the board
/ADC1/IN1: ADC1AIND1.1, IC8.7 (AIND+); also elsewhere on the board
/ADC1/IN2: ADC1AINC1.1, IC8.9 (AINC+); also elsewhere on the board
/ADC1/IN3: ADC1AINB1.1, IC8.11 (AINB+); also elsewhere on the board
/ADC1/IN4: ADC1_AINA1.1, IC8.13 (AINA+); also elsewhere on the board
GND: C38.2, C39.2, C40.2, C41.2, C42.2, C43.2, C44.2, IC8.1 (GND), IC8.5 (GND_2), IC8.14 (GND_3), IC8.16 (GND_4), IC8.25 (EP); also elsewhere on the board
unnamed: C39.1, IC8.15 (REFCAP)
unnamed: C38.1, IC8.3 (REGCAP)
unnamed: IC8.19 (SDOA), R8.1
unnamed: IC8.20 (SDOB), R9.1
unnamed: IC8.23 (SDOC), R10.1
unnamed: IC8.24 (SDOD/~ALERT), R11.1

Notes on the sheet:
Buffering for the ADC logic
Decoupling place next to every power pin of the ADC

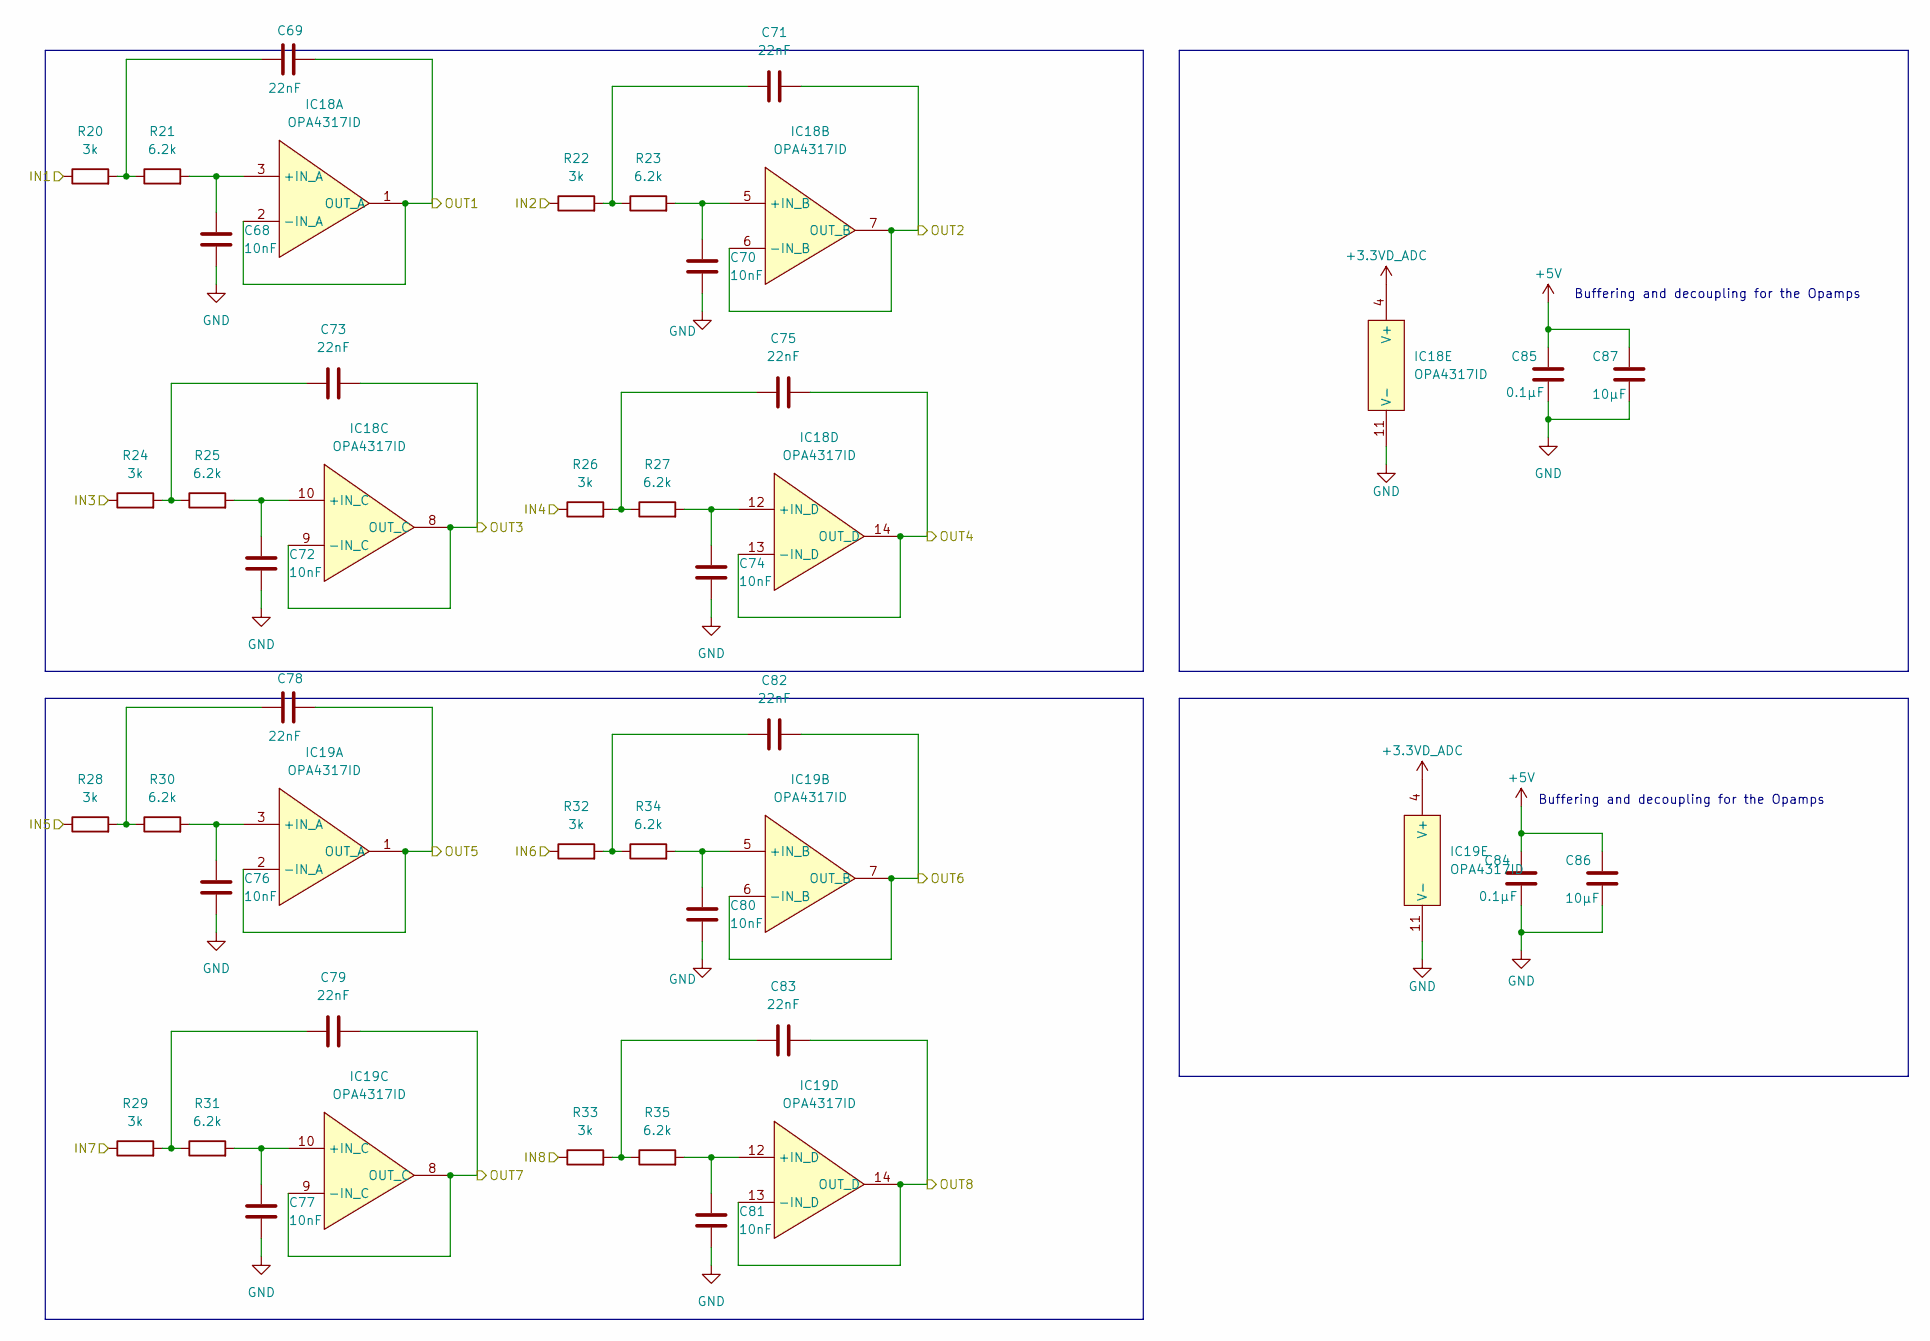
[picture p8: schematic DAC_filter.kicad_sch]

Parts:
C68, C70, C72, C74, C76, C77, C80, C81: 10nF; C_0402_1005Metric; Mouser Part Number 77-VJ0402Y103JXXAC
C69, C71, C73, C75, C78, C79, C82, C83: 22nF; C_0402_1005Metric; Mouser Part Number 581-04023C223JAT2A
C84, C85: 0.1µF; C_0402_1005Metric; Mouser Part Number 581-0402YC104JAT4A
C86, C87: 10µF; C_0603_1608Metric; Mouser Part Number 80-C0603C106J3RACTU
IC18, IC19: OPA4317ID; SOIC127P600X175-14N; Mouser Part Number 595-OPA4317ID
R20, R22, R24, R26, R28, R29, R32, R33: 3k; R_0603_1608Metric; Mouser Part Number 603-AR0603JR-073KL
R21, R23, R25, R27, R30, R31, R34, R35: 6.2k; R_0603_1608Metric; Mouser Part Number 603-AC0603JR-076K2L

Connections:
+3.3VD_ADC: IC18.4 (V+), IC19.4 (V+); also elsewhere on the board
+5V: C84.1, C85.1, C86.1, C87.1; also elsewhere on the board
/Connectors/OUT1: C69.2, IC18.1 (OUT_A), IC18.2 (-IN_A); also elsewhere on the board
/Connectors/OUT2: C71.2, IC18.6 (-IN_B), IC18.7 (OUT_B); also elsewhere on the board
/Connectors/OUT3: C73.2, IC18.8 (OUT_C), IC18.9 (-IN_C); also elsewhere on the board
/Connectors/OUT4: C75.2, IC18.13 (-IN_D), IC18.14 (OUT_D); also elsewhere on the board
/Connectors/OUT5: C78.2, IC19.1 (OUT_A), IC19.2 (-IN_A); also elsewhere on the board
/Connectors/OUT6: C82.2, IC19.6 (-IN_B), IC19.7 (OUT_B); also elsewhere on the board
/Connectors/OUT7: C79.2, IC19.8 (OUT_C), IC19.9 (-IN_C); also elsewhere on the board
/Connectors/OUT8: C83.2, IC19.13 (-IN_D), IC19.14 (OUT_D); also elsewhere on the board
/DAC/OUT1: R20.1; also elsewhere on the board
/DAC/OUT2: R22.1; also elsewhere on the board
/DAC/OUT3: R24.1; also elsewhere on the board
/DAC/OUT4: R26.1; also elsewhere on the board
/DAC/OUT5: R28.1; also elsewhere on the board
/DAC/OUT6: R32.1; also elsewhere on the board
/DAC/OUT7: R29.1; also elsewhere on the board
/DAC/OUT8: R33.1; also elsewhere on the board
GND: C68.2, C70.2, C72.2, C74.2, C76.2, C77.2, C80.2, C81.2, C84.2, C85.2, C86.2, C87.2, IC18.11 (V-), IC19.11 (V-); also elsewhere on the board
unnamed: C69.1, R20.2, R21.1
unnamed: C71.1, R22.2, R23.1
unnamed: C73.1, R24.2, R25.1
unnamed: C75.1, R26.2, R27.1
unnamed: C78.1, R28.2, R30.1
unnamed: C79.1, R29.2, R31.1
unnamed: C82.1, R32.2, R34.1
unnamed: C83.1, R33.2, R35.1
unnamed: C68.1, IC18.3 (+IN_A), R21.2
unnamed: C70.1, IC18.5 (+IN_B), R23.2
unnamed: C72.1, IC18.10 (+IN_C), R25.2
unnamed: C74.1, IC18.12 (+IN_D), R27.2
unnamed: C76.1, IC19.3 (+IN_A), R30.2
unnamed: C80.1, IC19.5 (+IN_B), R34.2
unnamed: C77.1, IC19.10 (+IN_C), R31.2
unnamed: C81.1, IC19.12 (+IN_D), R35.2

Notes on the sheet:
Buffering and decoupling for the Opamps

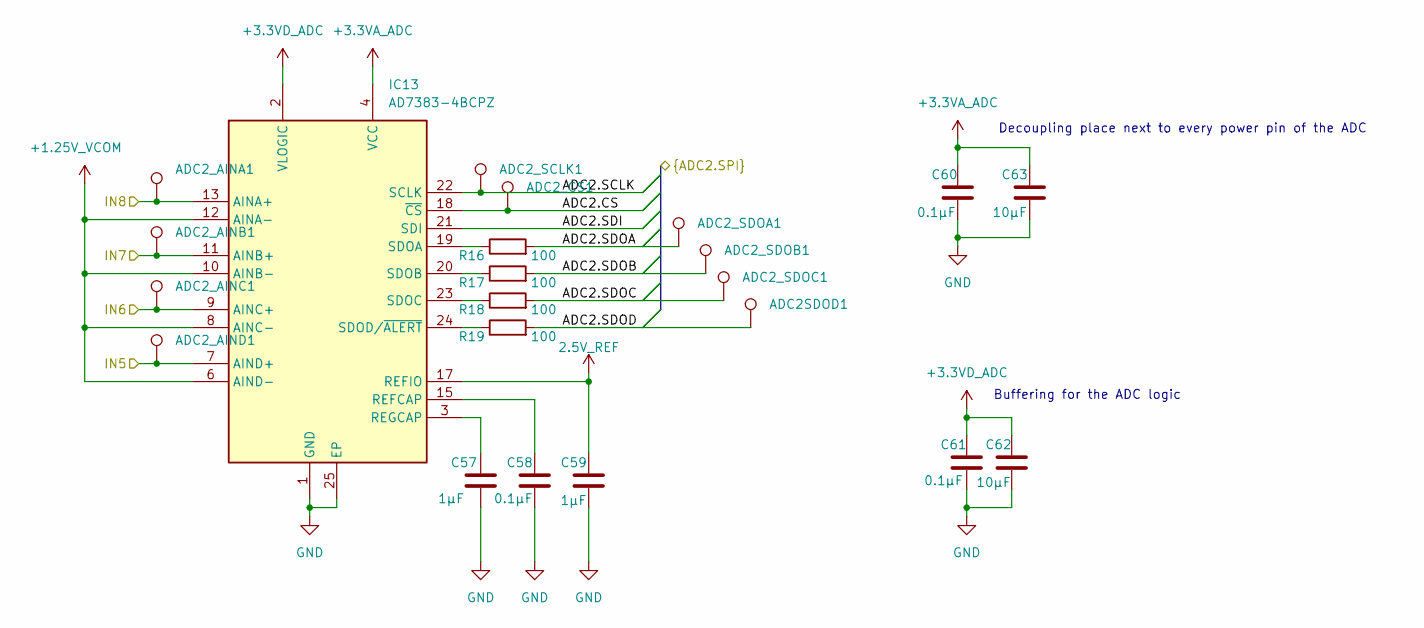
[picture p9: schematic ADC2.kicad_sch]

Parts:
ADC2SDOD1, ADC2_AINA1, ADC2_AINB1, ADC2_AINC1, ADC2_AIND1, ADC2_CS1, ADC2_SCLK1, ADC2_SDOA1, ADC2_SDOB1, ADC2_SDOC1: TestPoint; TestPoint_Keystone_5000-5004_Miniature
C57: 1µF; C_0402_1005Metric; Mouser Part Number 581-0402YC104JAT4A
C58, C60, C61: 0.1µF; C_0402_1005Metric; Mouser Part Number 581-0402YC104JAT4A
C59: 1µF; C_0603_1608Metric; Mouser Part Number 581-KGM15BR71A105JT
C62, C63: 10µF; C_0603_1608Metric; Mouser Part Number 80-C0603C106J3RACTU
IC13: AD7383-4BCPZ; QFN50P400X400X60-25N-D; Manufacturer_Part_Number AD7383-4BCPZ; Mouser Part Number 584-AD7383-4BCPZ
R16, R17, R18, R19: 100; R_0603_1608Metric; Mouser Part Number 71-RCG0603100RJNEA

Connections:
2.5V_REF: C59.1, IC13.17 (REFIO); also elsewhere on the board
+1.25V_VCOM: IC13.6 (AIND-), IC13.8 (AINC-), IC13.10 (AINB-), IC13.12 (AINA-); also elsewhere on the board
+3.3VA_ADC: C60.1, C63.1, IC13.4 (VCC); also elsewhere on the board
+3.3VD_ADC: C61.1, C62.1, IC13.2 (VLOGIC); also elsewhere on the board
/ADC2/ADC2.CS: ADC2_CS1.1, IC13.18 (~CS); also elsewhere on the board
/ADC2/ADC2.SCLK: ADC2_SCLK1.1, IC13.22 (SCLK); also elsewhere on the board
/ADC2/ADC2.SDI: IC13.21 (SDI); also elsewhere on the board
/ADC2/ADC2.SDOA: ADC2_SDOA1.1, R16.2; also elsewhere on the board
/ADC2/ADC2.SDOB: ADC2_SDOB1.1, R17.2; also elsewhere on the board
/ADC2/ADC2.SDOC: ADC2_SDOC1.1, R18.2; also elsewhere on the board
/ADC2/ADC2.SDOD: ADC2SDOD1.1, R19.2; also elsewhere on the board
/ADC2/IN5: ADC2_AIND1.1, IC13.7 (AIND+); also elsewhere on the board
/ADC2/IN6: ADC2_AINC1.1, IC13.9 (AINC+); also elsewhere on the board
/ADC2/IN7: ADC2_AINB1.1, IC13.11 (AINB+); also elsewhere on the board
/ADC2/IN8: ADC2_AINA1.1, IC13.13 (AINA+); also elsewhere on the board
GND: C57.2, C58.2, C59.2, C60.2, C61.2, C62.2, C63.2, IC13.1 (GND), IC13.5 (GND_2), IC13.14 (GND_3), IC13.16 (GND_4), IC13.25 (EP); also elsewhere on the board
unnamed: C58.1, IC13.15 (REFCAP)
unnamed: C57.1, IC13.3 (REGCAP)
unnamed: IC13.19 (SDOA), R16.1
unnamed: IC13.20 (SDOB), R17.1
unnamed: IC13.23 (SDOC), R18.1
unnamed: IC13.24 (SDOD/~ALERT), R19.1

Notes on the sheet:
Buffering for the ADC logic
Decoupling place next to every power pin of the ADC

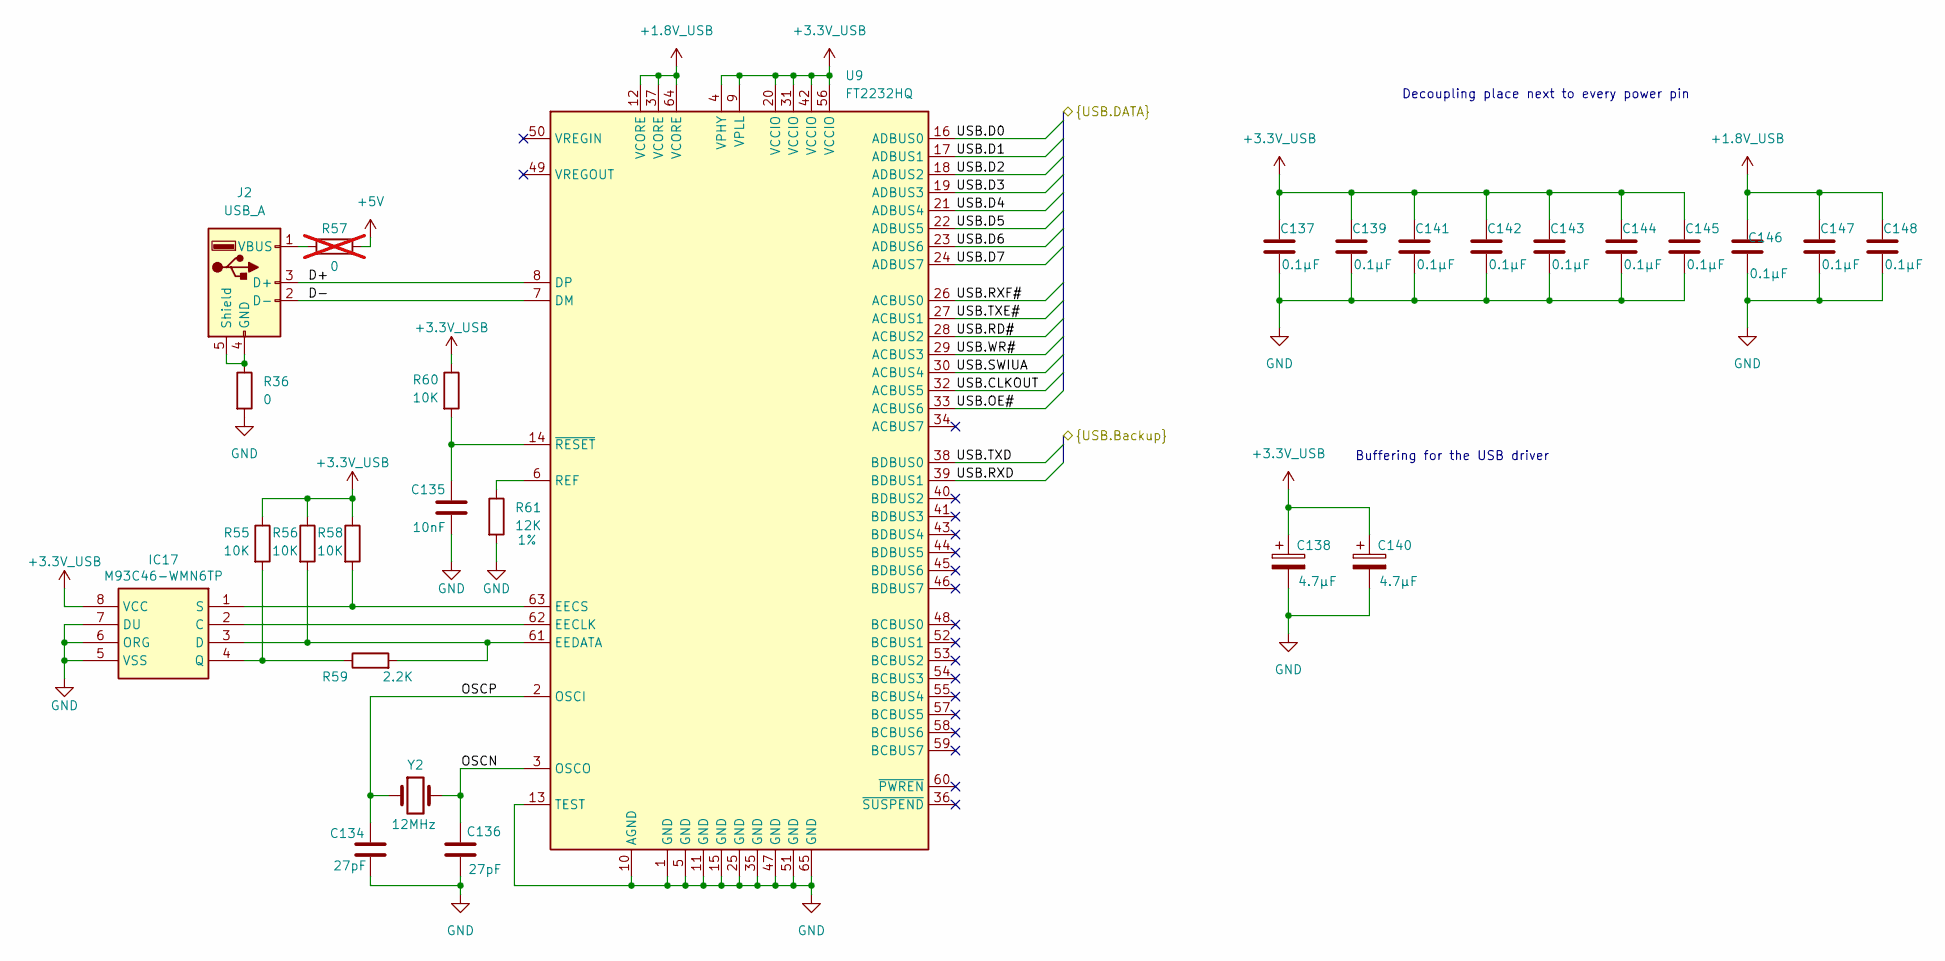
[picture p10: schematic USB.kicad_sch]

Parts:
C134, C136: 27pF; C_0402_1005Metric; Mouser Part Number 80-C0402T270J3GACTU
C135: 10nF; C_0402_1005Metric; Mouser Part Number 77-VJ0402Y103JXXAC
C137, C139, C141, C142, C143, C144, C145, C146, C147, C148: 0.1µF; C_0402_1005Metric; Mouser Part Number 581-0402YC104JAT4A
C138, C140: 4.7µF; CP_EIA-3216-12_Kemet-S; Mouser Part Number 71-293D475X5010A2TE3
IC17: M93C46-WMN6TP; SOIC127P600X175-8N; Manufacturer_Part_Number M93C46-WMN6TP; Mouser Part Number 511-M93C46-WMN6TP
J2: USB_A; TECONN-4POS-USB; Mouser Part Number 640-USB1015-GF-L-A
R36: 0; R_0603_1608Metric
R55, R56, R58, R60: 10K; R_0603_1608Metric; Mouser Part Number 71-RCA060310K0JNEA
R57: 0; R_0603_1608Metric; Mouser Part Number 791-WR06X000PTR; not fitted
R59: 2.2K; R_0603_1608Metric; Mouser Part Number 71-CRCW06032K20JNEBC
R61: 12K; R_0603_1608Metric; Mouser Part Number 71-CRCW0603J-12K
U9: FT2232HQ; QFN-64-1EP_9x9mm_P0.5mm_EP4.35x4.35mm
Y2: 12MHz; ABM3; Mouser Part Number 815-ABM3-12-D2Y-T

Connections:
+1.8VD: C146.2, C147.2, C148.2, U9.12 (VCORE), U9.37 (VCORE), U9.64 (VCORE); also elsewhere on the board
+3.3V_USB: C137.2, C138.1, C139.2, C140.1, C141.2, C142.2, C143.2, C144.2, C145.2, IC17.8 (VCC), R55.1, R56.1, R58.1, R60.1, U9.4 (VPHY), U9.9 (VPLL), U9.20 (VCCIO), U9.31 (VCCIO), U9.42 (VCCIO), U9.56 (VCCIO); also elsewhere on the board
+5V: R57.2; also elsewhere on the board
/FPGA/USB.CLKOUT: U9.32 (ACBUS5); also elsewhere on the board
/FPGA/USB.D0: U9.16 (ADBUS0); also elsewhere on the board
/FPGA/USB.D1: U9.17 (ADBUS1); also elsewhere on the board
/FPGA/USB.D2: U9.18 (ADBUS2); also elsewhere on the board
/FPGA/USB.D3: U9.19 (ADBUS3); also elsewhere on the board
/FPGA/USB.D4: U9.21 (ADBUS4); also elsewhere on the board
/FPGA/USB.D5: U9.22 (ADBUS5); also elsewhere on the board
/FPGA/USB.D6: U9.23 (ADBUS6); also elsewhere on the board
/FPGA/USB.D7: U9.24 (ADBUS7); also elsewhere on the board
/FPGA/USB.OE#: U9.33 (ACBUS6); also elsewhere on the board
/FPGA/USB.RD#: U9.28 (ACBUS2); also elsewhere on the board
/FPGA/USB.RXD: U9.39 (BDBUS1); also elsewhere on the board
/FPGA/USB.RXF#: U9.26 (ACBUS0); also elsewhere on the board
/FPGA/USB.SWIUA: U9.30 (ACBUS4); also elsewhere on the board
/FPGA/USB.TXD: U9.38 (BDBUS0); also elsewhere on the board
/FPGA/USB.TXE#: U9.27 (ACBUS1); also elsewhere on the board
/FPGA/USB.WR#: U9.29 (ACBUS3); also elsewhere on the board
/USB/D+: J2.3 (D+), U9.8 (DP)
/USB/D-: J2.2 (D-), U9.7 (DM)
/USB/OSCN: C136.1, U9.3 (OSCO), Y2.2
/USB/OSCP: C134.1, U9.2 (OSCI), Y2.1
GND: C134.2, C135.2, C136.2, C137.1, C138.2, C139.1, C140.2, C141.1, C142.1, C143.1, C144.1, C145.1, C146.1, C147.1, C148.1, IC17.5 (VSS), IC17.6 (ORG), IC17.7 (DU), R36.2, R61.2, U9.1 (GND), U9.5 (GND), U9.10 (AGND), U9.11 (GND), U9.13 (TEST), U9.15 (GND), U9.25 (GND), U9.35 (GND), U9.47 (GND), U9.51 (GND), U9.65 (GND); also elsewhere on the board
unnamed: IC17.2 (C), U9.62 (EECLK)
unnamed: IC17.3 (D), R56.2, R59.2, U9.61 (EEDATA)
unnamed: IC17.4 (Q), R55.2, R59.1
unnamed: IC17.1 (S), R58.2, U9.63 (EECS)
unnamed: J2.4 (GND), J2.5 (Shield), R36.1
unnamed: J2.1 (VBUS), R57.1
unnamed: R61.1, U9.6 (REF)
unnamed: C135.1, R60.2, U9.14 (~RESET)

Notes on the sheet:
Decoupling place next to every power pin
Buffering for the USB driver

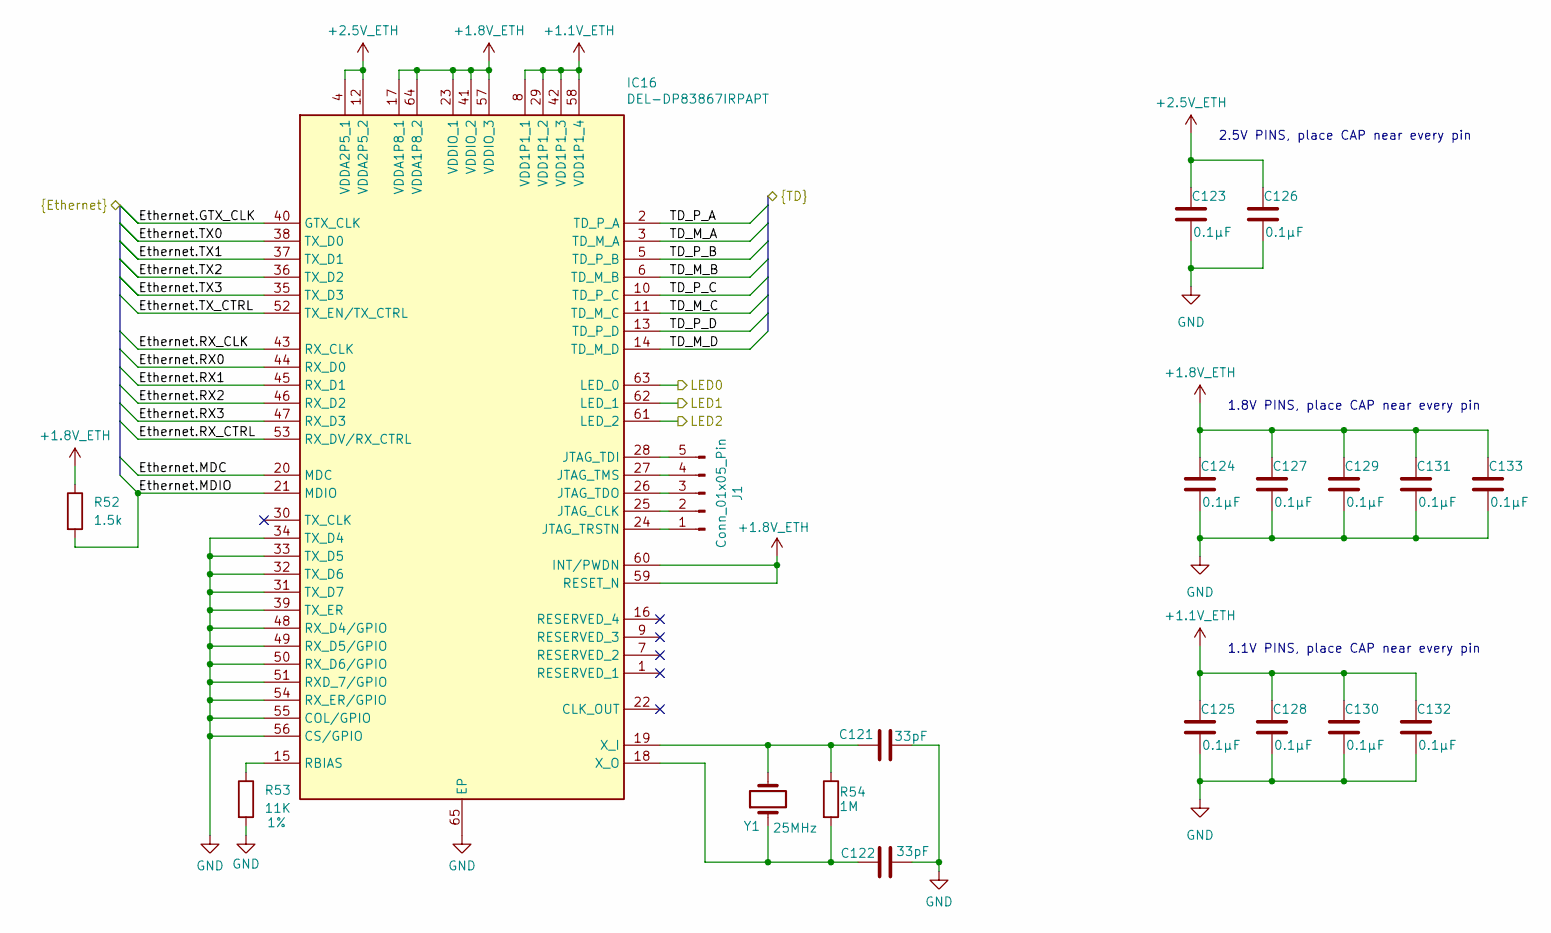
[picture p11: schematic Ethernet.kicad_sch]

Parts:
C121, C122: 33pF; C_0402_1005Metric; Mouser Part Number 581-0402NPO330JT2AT
C123, C124, C125, C126, C127, C128, C129, C130, C131, C132, C133: 0.1µF; C_0402_1005Metric; Mouser Part Number 581-0402YC104JAT4A
IC16: DEL-DP83867IRPAPT; QFP50P1200X1200X120-65N; Manufacturer_Part_Number DEL-DP83867IRPAPT
J1: Conn_01x05_Pin; PinHeader_1x05_P2.54mm_Vertical
R52: 1.5k; R_0402_1005Metric; Mouser Part Number 652-CR0603-JW-152ELF
R53: 11K; R_0603_1608Metric; Mouser Part Number 660-HV73V1JTTD113J
R54: 1M; R_0603_1608Metric; Mouser Part Number 755-SFR03EZPJ105
Y1: 25MHz; XTAL1140X470X330D1270L391X60N; Mouser Part Number 815-ABM325000B4YT

Connections:
+1.1V_ETH: C125.2, C128.2, C130.2, C132.2, IC16.8 (VDD1P1_1), IC16.29 (VDD1P1_2), IC16.42 (VDD1P1_3), IC16.58 (VDD1P1_4); also elsewhere on the board
+1.8VD: C124.2, C127.2, C129.2, C131.2, C133.2, IC16.17 (VDDA1P8_1), IC16.23 (VDDIO_1), IC16.41 (VDDIO_2), IC16.57 (VDDIO_3), IC16.59 (RESET_N), IC16.60 (INT/PWDN), IC16.64 (VDDA1P8_2), R52.1; also elsewhere on the board
+2.5V_ETH: C123.2, C126.2, IC16.4 (VDDA2P5_1), IC16.12 (VDDA2P5_2); also elsewhere on the board
/Connectors/LED0: IC16.63 (LED_0); also elsewhere on the board
/Connectors/LED1: IC16.62 (LED_1); also elsewhere on the board
/Connectors/LED2: IC16.61 (LED_2); also elsewhere on the board
/Connectors/TD_M_A: IC16.3 (TD_M_A); also elsewhere on the board
/Connectors/TD_M_B: IC16.6 (TD_M_B); also elsewhere on the board
/Connectors/TD_M_C: IC16.11 (TD_M_C); also elsewhere on the board
/Connectors/TD_M_D: IC16.14 (TD_M_D); also elsewhere on the board
/Connectors/TD_P_A: IC16.2 (TD_P_A); also elsewhere on the board
/Connectors/TD_P_B: IC16.5 (TD_P_B); also elsewhere on the board
/Connectors/TD_P_C: IC16.10 (TD_P_C); also elsewhere on the board
/Connectors/TD_P_D: IC16.13 (TD_P_D); also elsewhere on the board
/Ethernet/Ethernet.GTX_CLK: IC16.40 (GTX_CLK); also elsewhere on the board
/Ethernet/Ethernet.MDC: IC16.20 (MDC); also elsewhere on the board
/Ethernet/Ethernet.MDIO: IC16.21 (MDIO), R52.2; also elsewhere on the board
/Ethernet/Ethernet.RX0: IC16.44 (RX_D0); also elsewhere on the board
/Ethernet/Ethernet.RX1: IC16.45 (RX_D1); also elsewhere on the board
/Ethernet/Ethernet.RX2: IC16.46 (RX_D2); also elsewhere on the board
/Ethernet/Ethernet.RX3: IC16.47 (RX_D3); also elsewhere on the board
/Ethernet/Ethernet.RX_CLK: IC16.43 (RX_CLK); also elsewhere on the board
/Ethernet/Ethernet.RX_CTRL: IC16.53 (RX_DV/RX_CTRL); also elsewhere on the board
/Ethernet/Ethernet.TX0: IC16.38 (TX_D0); also elsewhere on the board
/Ethernet/Ethernet.TX1: IC16.37 (TX_D1); also elsewhere on the board
/Ethernet/Ethernet.TX2: IC16.36 (TX_D2); also elsewhere on the board
/Ethernet/Ethernet.TX3: IC16.35 (TX_D3); also elsewhere on the board
/Ethernet/Ethernet.TX_CTRL: IC16.52 (TX_EN/TX_CTRL); also elsewhere on the board
GND: C121.2, C122.2, C123.1, C124.1, C125.1, C126.1, C127.1, C128.1, C129.1, C130.1, C131.1, C132.1, C133.1, IC16.31 (TX_D7), IC16.32 (TX_D6), IC16.33 (TX_D5), IC16.34 (TX_D4), IC16.39 (TX_ER), IC16.48 (RX_D4/GPIO), IC16.49 (RX_D5/GPIO), IC16.50 (RX_D6/GPIO), IC16.51 (RXD_7/GPIO), IC16.54 (RX_ER/GPIO), IC16.55 (COL/GPIO), IC16.56 (CS/GPIO), IC16.65 (EP), R53.2; also elsewhere on the board
unnamed: IC16.25 (JTAG_CLK), J1.2
unnamed: IC16.28 (JTAG_TDI), J1.5
unnamed: IC16.26 (JTAG_TDO), J1.3
unnamed: IC16.27 (JTAG_TMS), J1.4
unnamed: IC16.24 (JTAG_TRSTN), J1.1
unnamed: IC16.15 (RBIAS), R53.1
unnamed: C121.1, IC16.19 (X_I), R54.1, Y1.2
unnamed: C122.1, IC16.18 (X_O), R54.2, Y1.1

Notes on the sheet:
1.8V PINS, place CAP near every pin
1.1V PINS, place CAP near every pin
2.5V PINS, place CAP near every pin

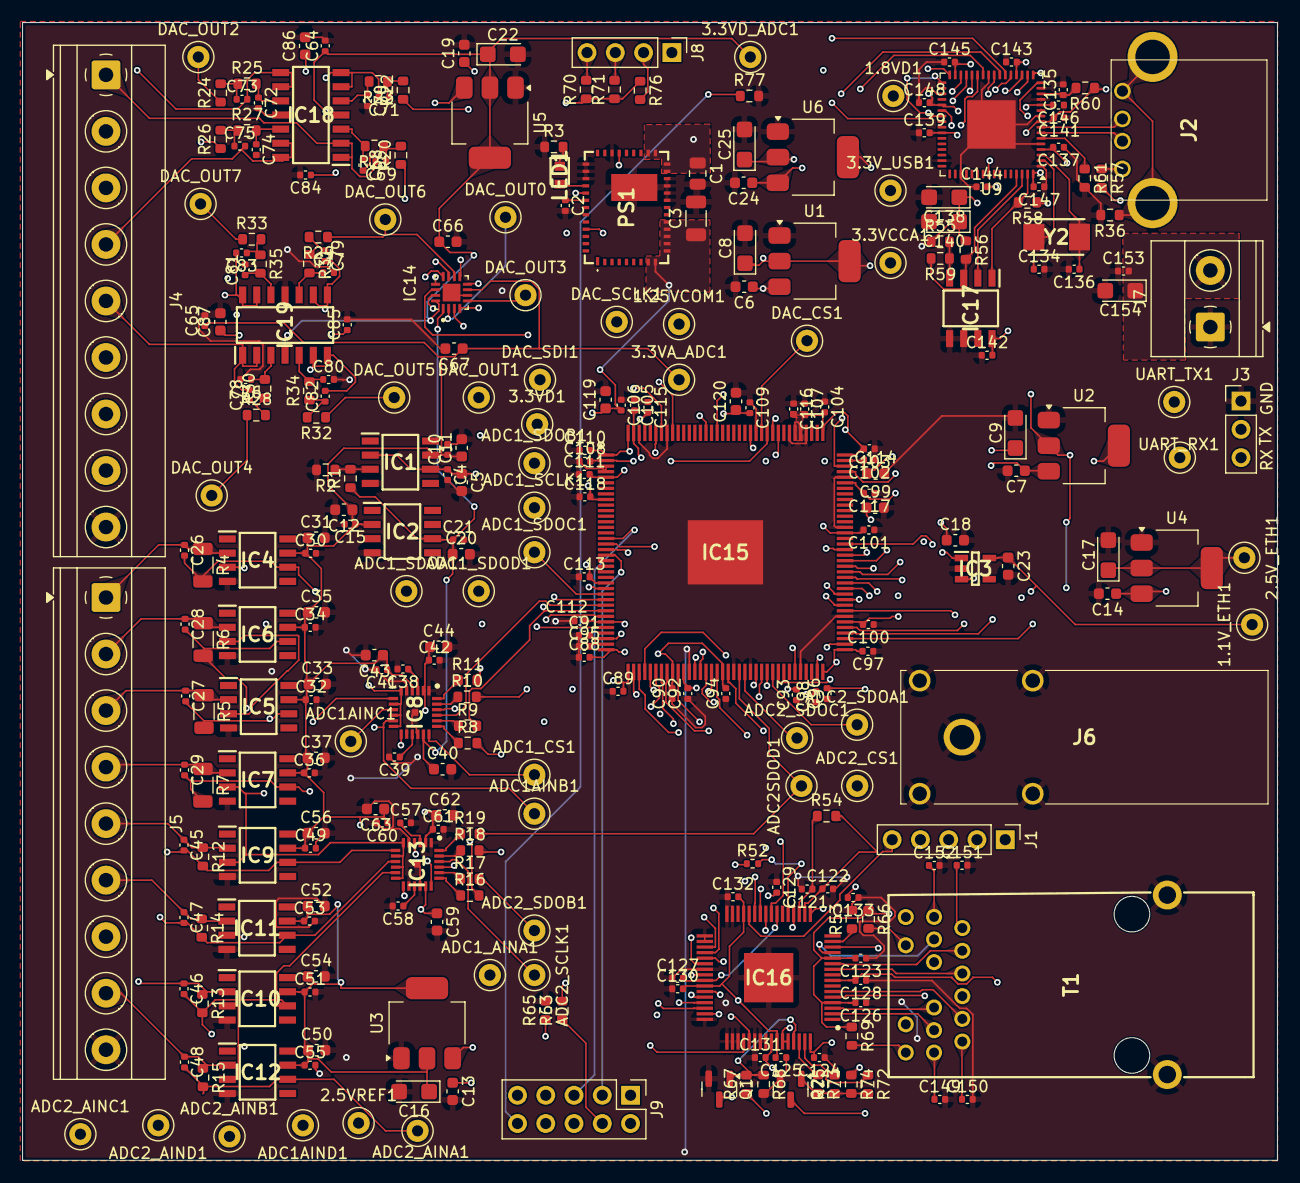
[picture p12: board Nanopipetes.kicad_pcb from above]

Board: 4 copper layers, 112.8 x 102.2 mm, 298 parts (0 on the bottom side), 178 nets.
