rasero3/Nanopipets/(commit log)

2025-09-30 Agregar nuevos contenidos de la carpeta
    [ADC.kicad_sch, ADC1.kicad_sch, ADC1_buffer.kicad_sch, ADC2.kicad_sch, ADC2_buffer.kicad_sch, Connectors.kicad_sch, DAC.kicad_sch, DAC_filter.kicad_sch]
2025-11-24 Versión pre 24/11/2025
    Generación y leido de un voltaje estable por 8 canales
2025-11-24 Ramp v0.01
    Updating que output adding +1 integer every cycle
    Test Bench of a single channel
2025-11-26 Ramp V0.02
    Implemented 8 channel paralel output + ramp negative slope
    Old testbench reused
    Needs to fix:
    -Index reapeats the first number twice
    [NanoPipets_TB.vhd, Uart_receive.vhd]
2025-11-27 ramp v1.00
    Now the uart_flag activates the uart_state 3 when finished so it could start saving the info, when the matrix is full it will start generating the ramp (ramp generation still in developement)
    Also the uart might start sending the info by LSB first so the to_int conversion is easy-er
2025-11-27 ramp v1.01
    finished the block (receive uart inverted)
    [Uart_receive.vhd]
2025-12-01 MatLab
    The Matlab File was missing
    Pending:
    -not inverting the output
    -sending uart even when the voltaje is 0
2025-12-01 Expand project description in README
    Added details about the data flow and DAC functionality.
2025-12-02 Cambios en KiCad
    [ADC.kicad_sch, ADC1.kicad_sch, ADC1_buffer.kicad_sch, ADC2.kicad_sch, ADC2_buffer.kicad_sch, Connectors.kicad_sch, DAC.kicad_sch, DAC_filter.kicad_sch]
2025-12-02 kicad v 1.03
    [DAC_filter.kicad_sch, IV_Converter1.kicad_sch, IV_Converter2.kicad_sch, Nanopipetes.kicad_pcb, USB.kicad_sch]
